Siwachanat/ExArMo/Logbook_Capstan_Drive_Performance_TH.docx

บันทึกการปฏิบัติงานโครงงาน (Project Logbook)

การทดสอบและหาประสิทธิภาพชุดส่งกำลังแคปสแตน

Capstan Drive Performance Test

หัวข้อ | รายละเอียด
โครงงาน | ExArMo — อุปกรณ์ฟื้นฟูข้อศอกแบบสวมใส่ 1 องศาอิสระ (1-DOF Elbow Exoskeleton)
ส่วนของงาน | การทดสอบอัตราทดและประสิทธิภาพของชุดส่งกำลังแคปสแตน
การจัดวาง A | คานยาว 10 cm ต่อกับแกนมอเตอร์โดยตรง (Direct drive)
การจัดวาง B | คานยาว 10 cm ต่อกับดรัมขาออกของชุดแคปสแตน (Through capstan)
วิธีการ | ปรับค่ากระแส I_q เป็นขั้น ๆ แล้ววัดแรงด้วยโหลดเซลล์ (ชุดทดสอบเดียวกับ logbook ค่า K_t วิธีที่ 2)
ชุดส่งกำลัง | Capstan Drive อัตราทดออกแบบ 9 : 1 (ดรัม ⌀11 มม. และ ⌀99 มม., เชือก ⌀2 มม.)
มอเตอร์ | มอเตอร์ที่พันใหม่ 40 รอบ/ฟัน ต่อแบบสตาร์ (K_t = 0.10148 N·m/A)
ไฟล์ข้อมูลดิบ | Test40.csv (direct drive, 80 แถว) และ foc_loadcell_capstan.csv (ผ่านแคปสแตน, 60 แถว)
วันที่เก็บข้อมูล | 12 กรกฎาคม 2569 · วิเคราะห์ผล 16 สิงหาคม 2569
ผู้บันทึก | .................................................................
สถานะ | ☑ ทดลองแล้ว ☑ วิเคราะห์ผลแล้ว ☐ ยืนยันอัตราทดเชิงจลนศาสตร์ ☐ วัดขาลง

# 1. วัตถุประสงค์ของการทดลอง

ในสองการทดลองก่อนหน้านี้เราได้พิสูจน์แล้วว่ามอเตอร์ที่พันใหม่ให้ค่าคงตัวแรงบิดตามทฤษฎี และเราได้ออกแบบชุดส่งกำลังแคปสแตนที่มีอัตราทดตามแบบ 9 : 1 การทดลองนี้เป็นขั้นตอนสุดท้ายของการยืนยันสายส่งกำลังทั้งเส้น คือวัดว่าเมื่อประกอบทุกอย่างเข้าด้วยกันแล้ว แรงบิดที่ออกมาที่ข้อต่อจริง ๆ เป็นเท่าไร

- วัด อัตราขยายแรงบิดรวม (i · η) ของชุดแคปสแตนจากการทดลองจริง
- แยกค่า อัตราทดจริง (i) ออกจาก ประสิทธิภาพเชิงกล (η) เพื่อไม่ให้สับสนระหว่างความคลาดเคลื่อนทางเรขาคณิตกับการสูญเสียพลังงาน
- วัด แรงเสียดทานสถิตที่ชุดแคปสแตนเพิ่มเข้ามา ซึ่งเป็นตัวกำหนดว่าผู้ใช้ต้องออกแรงเท่าไรจึงจะเริ่มขยับแขนกลได้
- ยืนยันว่าแรงบิดที่ข้อต่อเพียงพอต่องานกายภาพบำบัดข้อศอกที่ต้องการประมาณ 2 ถึง 3 N·m

แนวคิดหลักของการทดลอง เราวัดสองครั้งด้วยชุดทดสอบเดียวกัน คานยาวเท่ากัน และโหลดเซลล์ตัวเดียวกัน ต่างกันแค่ว่าคานติดอยู่กับแกนมอเตอร์โดยตรง หรือติดอยู่กับดรัมขาออกของแคปสแตน แล้วนำผลทั้งสองมาหารกัน วิธีนี้ทำให้ความคลาดเคลื่อนที่เหมือนกันทั้งสองครั้งหักล้างกันหมด ซึ่งเป็นจุดแข็งที่สุดของการออกแบบการทดลองนี้ (ดูข้อ 2.2)

# 2. ทฤษฎี

## 2.1 สมการพื้นฐานของชุดส่งกำลัง

ชุดส่งกำลังที่มีอัตราทด i และประสิทธิภาพเชิงกล η จะแปลงแรงบิดขาเข้าเป็นแรงบิดขาออกตามสมการ

τ_out = i · η · τ_in ω_out = ω_in / i

เมื่อรวมกับความสัมพันธ์ระหว่างแรงบิดกับกระแสของมอเตอร์ที่เราหาไว้แล้วในการทดลองค่า K_t จะได้

การจัดวาง A : τ_A = K_t · I_q + b_A

การจัดวาง B : τ_B = ( i · η · K_t ) · I_q + b_B

ดังนั้นถ้าเราพล็อตแรงบิดที่วัดได้เทียบกับกระแสในทั้งสองการจัดวาง แล้วหาความชันของแต่ละเส้น ความชันของเส้น B จะมากกว่าความชันของเส้น A อยู่เท่ากับ i · η พอดี

i · η = ความชัน_B / ความชัน_A

## 2.2 ทำไมการวัดแบบเทียบสองการจัดวางจึงแม่นยำเป็นพิเศษ

จุดแข็งของวิธีนี้อยู่ที่การนำผลสองชุดมาหารกัน เพราะความคลาดเคลื่อนที่ปรากฏเหมือนกันในทั้งสองการวัดจะถูกหักล้างไปหมด

แหล่งความคลาดเคลื่อน | มีผลต่อการวัดเดี่ยว | มีผลต่ออัตราส่วน B ÷ A
ค่าตัวคูณของโหลดเซลล์ | มีผลเต็มที่ | หักล้างหมด (ใช้เซลล์ตัวเดียวกัน)
ระยะแขน r ของคาน | มีผลเต็มที่ | หักล้างหมด (ใช้คานเดียวกัน)
ค่า K_t ของมอเตอร์ | มีผลเต็มที่ | หักล้างหมด (มอเตอร์ตัวเดียวกัน)
ความคลาดเคลื่อนของค่ากระแส I_q ที่รายงาน | มีผลเต็มที่ | หักล้างหมด
ความตั้งฉากของแรงที่กระทำต่อโหลดเซลล์ | มีผลเต็มที่ | หักล้างบางส่วน ถ้าจัดวางเหมือนกัน

เงื่อนไขสำคัญ ประโยชน์ข้อนี้จะเกิดขึ้นก็ต่อเมื่อใช้ โหลดเซลล์ตัวเดียวกัน คานความยาวเท่ากัน และมอเตอร์ตัวเดียวกัน ในทั้งสองการจัดวาง ถ้าเปลี่ยนโหลดเซลล์เพราะพิกัดไม่พอ ความคลาดเคลื่อนจะไม่หักล้างกันอีกต่อไป และต้องสอบเทียบเซลล์ทั้งสองตัวด้วยตุ้มน้ำหนักมาตรฐานชุดเดียวกันแทน

## 2.3 การแยกอัตราทดจริงออกจากประสิทธิภาพ

การทดลองนี้วัดได้โดยตรงเพียงผลคูณ i · η เท่านั้น ไม่สามารถแยกสองตัวนี้ออกจากกันได้ด้วยตัวมันเอง จึงต้องหาค่า i จากแหล่งอื่นก่อน

วิธีหาค่า i | วิธีทำ | ข้อจำกัด
จากแบบทางเรขาคณิต | i = D₂ / D₁ = 99 / 11 = 9.00 | ถ้าร่องเชือกลึกไม่ตรงตามแบบ ค่าจริงจะเพี้ยน
วัดจากเอนโคดเดอร์ (แนะนำ) | หมุนขาออกไปหนึ่งช่วงมุมที่ทราบ แล้วนับมุมที่แกนมอเตอร์หมุนไป i = Δθ_มอเตอร์ / Δθ_ขาออก | ต้องมีเอนโคดเดอร์ทั้งสองฝั่ง หรือวัดมุมขาออกด้วยเครื่องมือ

ทำไมต้องวัด i แยกต่างหาก ใน logbook การออกแบบแคปสแตนเราพบว่า ถ้าร่องเชือกไม่ได้ลึกครึ่งหนึ่งของเส้นผ่านศูนย์กลางเชือก แนวศูนย์กลางเชือกจะเลื่อนไปอยู่ที่ ⌀13 และ ⌀101 ทำให้อัตราทดจริงเหลือเพียง 7.77 แทนที่จะเป็น 9.00 ถ้าเราเหมาเอาว่า i = 9 เสมอ ความคลาดเคลื่อนทางเรขาคณิตนี้จะไปโผล่เป็นค่า η ที่ต่ำผิดปกติ ทำให้สรุปผิดว่าชุดส่งกำลังมีประสิทธิภาพแย่ ทั้งที่จริงแล้วปัญหาอยู่ที่ขนาดของร่อง

เกณฑ์ตรวจสอบง่าย ๆ: ถ้าค่า i · η ที่วัดได้ มากกว่า 9 แสดงว่าอัตราทดจริงต้องมากกว่า 9 แน่นอน เพราะประสิทธิภาพเป็นไปไม่ได้ที่จะเกิน 100 % ในกรณีนั้นให้กลับไปวัดขนาดดรัมและความลึกร่องใหม่

## 2.4 ความหมายของความชันกับจุดตัดแกน

เช่นเดียวกับการทดลองหาค่า K_t เส้นตรงที่ได้จากการทดลองนี้มีสองส่วนที่มีความหมายทางกายภาพต่างกัน และต้องตีความแยกกัน

ส่วนของเส้นตรง | ความหมายทางกายภาพ | สิ่งที่บอกเราได้
ความชัน | การสูญเสียที่แปรผันตามภาระ เช่น ความฝืดของแบริ่งที่เพิ่มตามแรงตึงเชือก และการสูญเสียภายในเนื้อเชือก | ค่า i · η ที่ใช้คำนวณประสิทธิภาพ
จุดตัดแกน b | แรงบิดที่ระบบต้านได้เองโดยไม่ต้องใช้กระแส คือ cogging torque บวกแรงเสียดทานสถิตของแบริ่งและเชือก | แรงที่ผู้ใช้ต้องออกก่อนแขนกลจะเริ่มขยับ (สำคัญมากต่อความรู้สึกในการใช้งาน)

แรงเสียดทานที่ชุดแคปสแตนเพิ่มเข้ามาเอง หาได้จากการเทียบจุดตัดแกนของทั้งสองการจัดวาง โดยต้องแปลงจุดตัดแกนของการจัดวาง A ให้ไปอยู่ที่ฝั่งขาออกก่อน

τ_เสียดทาน,แคปสแตน = b_B − ( i · η ) · b_A

ค่านี้บอกโดยตรงว่าถ้าผู้ใช้จับแขนกลแล้วออกแรงหมุน จะต้องออกแรงบิดอย่างน้อยเท่าไรจึงจะเอาชนะความฝืดของระบบได้ ซึ่งเป็นตัวเลขที่ใช้ตัดสินคุณสมบัติ Backdrivability ได้ตรงที่สุด

## 2.5 ประสิทธิภาพขึ้นกับจุดทำงาน

เนื่องจากมีทั้งส่วนที่แปรผันตามภาระและส่วนที่คงที่ ประสิทธิภาพโดยรวมจึงไม่ใช่ตัวเลขตัวเดียว แต่เปลี่ยนไปตามแรงบิดที่ใช้งาน

η(I_q) = ( ความชัน_B · I_q + b_B ) / [ i · ( ความชัน_A · I_q + b_A ) ]

- ที่แรงบิดต่ำ ค่า b ครองสัดส่วนใหญ่ ประสิทธิภาพจึงต่ำ
- ที่แรงบิดสูง ผลของ b เจือจางลง ประสิทธิภาพจึงเข้าใกล้ค่าที่ได้จากอัตราส่วนความชัน
- เวลารายงานค่าประสิทธิภาพต้องระบุเสมอว่าเป็นค่าที่จุดทำงานใด มิฉะนั้นตัวเลขจะเทียบกันไม่ได้

## 2.6 ค่าที่คาดการณ์ไว้ล่วงหน้า

จากค่า K_t = 0.10148 N·m/A ที่วัดได้ในการทดลองก่อนหน้า และอัตราทดออกแบบ 9 : 1 เราคาดว่าจะได้ค่าดังตาราง

สมมติฐาน | ความชัน B (N·m/A) | แรงบิดที่ I_q = 4 A | แรงที่คาน 10 cm
η = 1.00 (ไม่มีการสูญเสีย) | 0.9133 | 3.65 N·m | 36.5 N (3.7 kg)
η = 0.90 | 0.8220 | 3.29 N·m | 32.9 N (3.4 kg)
η = 0.87 | 0.7946 | 3.18 N·m | 31.8 N (3.2 kg)
η = 0.80 | 0.7307 | 2.92 N·m | 29.2 N (3.0 kg)

ส่วนการจัดวาง A ที่กระแสเดียวกัน 4 A จะได้แรงบิด 0.406 N·m คิดเป็นแรงที่คานเพียง 4.06 N หรือประมาณ 414 กรัม

[ วางรูปที่นี่ / Insert image here ]

แผนภาพหลักการทดลอง — เปรียบเทียบการจัดวาง A (ต่อแกนมอเตอร์ตรง) กับ B (ผ่านชุดแคปสแตน)

รูปที่ 1 แผนภาพหลักการทดลอง — เปรียบเทียบการจัดวาง A (ต่อแกนมอเตอร์ตรง) กับ B (ผ่านชุดแคปสแตน)

# 3. เทคนิคและวิธีการทดลอง

## 3.1 ชุดทดสอบ

ใช้ชุดทดสอบเดียวกับที่พัฒนาไว้ในการวัดค่า K_t วิธีที่ 2 คือโหลดเซลล์ต่อกับบอร์ด Arduino ส่งค่าเข้าโปรแกรม Python GUI พร้อมกับค่ากระแส I_q จากเฟิร์มแวร์ SimpleFOC แล้วบันทึกทั้งสองค่าพร้อมเวลาลงไฟล์ CSV

รายการ | การจัดวาง A (Direct) | การจัดวาง B (Through capstan)
คานติดที่ไหน | แกนมอเตอร์โดยตรง | ดรัมขาออก ⌀99 มม. ของแคปสแตน
ความยาวคาน | 10 cm | 10 cm (คานเดียวกัน)
โหลดเซลล์ | ตัวเดียวกัน | ตัวเดียวกัน
สิ่งที่วัดได้ | K_t ของมอเตอร์ | K_t × i × η ที่ข้อต่อ
ช่วงแรงที่คาดว่าจะเจอ | 0 ถึงประมาณ 4 N | 0 ถึงประมาณ 37 N

## 3.2 การเลือกพิกัดของโหลดเซลล์

นี่คือประเด็นที่ต้องวางแผนก่อนเริ่มทดลอง เพราะแรงที่เกิดขึ้นในสองการจัดวางต่างกันเกือบสิบเท่า

- ถ้าใช้โหลดเซลล์ตัวเดียวกันทั้งสองการจัดวาง ความคลาดเคลื่อนจะหักล้างกันตามข้อ 2.2 ซึ่งเป็นข้อดีที่สำคัญมาก แต่ต้องเลือกพิกัดให้ครอบคลุมแรงสูงสุดของการจัดวาง B คือประมาณ 5 กิโลกรัม และในการจัดวาง A เราจะใช้เพียงราว 8 % ของพิกัดเท่านั้น
- ข้อควรระวัง: ความแม่นยำของโหลดเซลล์มักระบุเป็นเปอร์เซ็นต์ของพิกัดเต็ม ดังนั้นการวัดที่เพียง 8 % ของพิกัดจะมีความคลาดเคลื่อนสัมพัทธ์สูงกว่าปกติราวสิบเท่า ต้องเก็บจุดข้อมูลให้มากเพื่อชดเชยด้วยการเฉลี่ยทางสถิติ
- ทางเลือก: ถ้าจำเป็นต้องใช้โหลดเซลล์คนละตัว ต้องสอบเทียบทั้งสองตัวด้วยตุ้มน้ำหนักมาตรฐานชุดเดียวกัน และต้องรายงานความไม่แน่นอนของการสอบเทียบเข้าไปในผลด้วย เพราะข้อดีเรื่องการหักล้างความคลาดเคลื่อนหายไปแล้ว

## 3.3 ขั้นตอนการทดลอง

1. วัดอัตราทดจริง i ก่อนเป็นอันดับแรก โดยหมุนดรัมขาออกไปหนึ่งช่วงมุมที่ทราบค่า แล้วอ่านมุมที่แกนมอเตอร์หมุนไปจากเอนโคดเดอร์ ทำซ้ำหลายครั้งแล้วเฉลี่ย
2. ตั้งความตึงเชือกให้ได้ตามที่กำหนด แล้วบันทึกวิธีตั้งไว้ให้ชัดเจน เพราะความตึงมีผลต่อทั้งความฝืดและความแข็งของระบบ
3. ประกอบการจัดวาง A ติดคานเข้ากับแกนมอเตอร์ จัดให้คานอยู่แนวระนาบและกดตรงแกนวัดของโหลดเซลล์
4. ตั้งศูนย์โหลดเซลล์ขณะยังไม่จ่ายกระแส แล้วตั้งเฟิร์มแวร์เป็นโหมดแรงบิดพร้อมจำกัดกระแสสูงสุด
5. แรมป์ค่า I_q ขึ้นทีละขั้นอย่างช้า ๆ จนถึงค่าสูงสุดที่กำหนด แล้วลดกลับลงมาที่ศูนย์ตามเส้นทางเดิม บันทึกลง CSV
6. ถอดคานออก ประกอบชุดแคปสแตน แล้วติดคานตัวเดิมเข้ากับดรัมขาออก จัดวางให้เหมือนเดิมทุกประการ
7. ทำซ้ำขั้นตอนที่ 4 และ 5 สำหรับการจัดวาง B
8. ทำซ้ำทั้งชุดในทิศทางการหมุนตรงข้าม เพราะชุดแคปสแตนอาจมีความฝืดไม่เท่ากันในสองทิศทาง
9. นำไฟล์ CSV มาฟิตเส้นตรงแบบมีจุดตัดแกน หาความชันและจุดตัดแกนของแต่ละการจัดวาง แล้วคำนวณตามสมการในข้อ 2

## 3.4 กติกาการทำความสะอาดข้อมูลที่ใช้จริง

ข้อมูลดิบเก็บที่ขั้นกระแสละ 0.2 A ค้างขั้นละประมาณ 2 วินาที ได้ประมาณ 4 แซมเปิลต่อขั้น (คาบการสุ่มราว 0.5 วินาที) ก่อนนำไปฟิตเส้นตรงได้กำหนดกติกาการคัดข้อมูลไว้สามข้อ

1. ตัดสองแซมเปิลแรกของทุกขั้นกระแสทิ้ง เพราะค่าน้ำหนักจากโหลดเซลล์ตอบสนองช้ากว่ากระแสประมาณหนึ่งคาบการสุ่ม แซมเปิลแรกจึงยังเป็นน้ำหนักของขั้นก่อนหน้า และกระแสยังอยู่ในช่วงเปลี่ยนผ่าน แล้วใช้ค่าเฉลี่ยของสองแซมเปิลท้ายที่เป็นช่วงคงตัวแทน
2. ฝั่งแคปสแตน ตัดขั้น 0.2 A และ 0.4 A ทิ้งทั้งหมด เพราะค่าน้ำหนักที่อ่านได้เกือบเป็นศูนย์ และตำแหน่งเชิงมุมยังอยู่ที่ประมาณ −4.2 rad แสดงว่าแขนยังหมุนเก็บระยะหย่อนของระบบอยู่ ยังไม่สัมผัสโหลดเซลล์ พอถึงขั้น 0.6 A ตำแหน่งกระโดดไปที่ +2.5 rad จึงถือว่าเริ่มสัมผัส
3. ใช้ค่า I_q ที่วัดได้จริงเป็นแกน x ไม่ใช่ค่าเป้าหมายที่สั่ง เพราะกระแสจริงเบี่ยงจากค่าเป้าหมายได้มาก เช่นขั้นที่สั่ง 1.8 A วัดได้จริง 2.013 A

เหตุผลที่ไม่บังคับเส้นให้ผ่านจุดกำเนิด ระบบมีออฟเซตจริงจากแรงเสียดทานสถิตและแรงตึงเริ่มต้นของเชือก ถ้าบังคับให้เส้นผ่านศูนย์ ออฟเซตนั้นจะไปบิดค่าความชัน ในกรณีนี้ถ้าบังคับผ่านศูนย์จะได้อัตราขยาย 8.95 ซึ่งแปลว่าประสิทธิภาพ 99.5 % ซึ่งสูงเกินจริงอย่างชัดเจน เป็นบทเรียนเดียวกับที่พบในการทดลองหาค่า K_t

## 3.5 เทคนิคที่ทำให้ผลการวัดเชื่อถือได้

- ใช้คานตัวเดิมและโหลดเซลล์ตัวเดิม และอย่าเปลี่ยนจุดยึดหรือระยะ r ระหว่างสองการจัดวาง นี่คือเงื่อนไขที่ทำให้ความคลาดเคลื่อนหักล้างกัน
- วัดทั้งสองการจัดวางในวันเดียวกัน เพราะอุณหภูมิมีผลต่อทั้งค่า K_t ของมอเตอร์และการดริฟต์ของโหลดเซลล์
- ดึงเชือกทิ้งไว้ก่อนติดตั้ง (Pre-stretch) และตั้งความตึงใหม่ก่อนเริ่ม เพราะเชือกที่ยังไม่ผ่านการยืดตัวจะคลายตัวระหว่างทดลอง ทำให้ความชันไหลลง
- วัดซ้ำที่หลายตำแหน่งเชิงมุมของดรัม เพราะทั้ง cogging torque ของมอเตอร์และตำแหน่งของเชือกบนร่องเปลี่ยนไปตามมุม
- เก็บทั้งขาขึ้นและขาลง ผลต่างระหว่างสองขาคือขนาดของฮิสเทอรีซิสจากแรงเสียดทาน ซึ่งเป็นข้อมูลที่มีค่าในตัวเอง
- ตรวจว่าเชือกไม่ลื่นระหว่างการทดลอง โดยทำเครื่องหมายที่เชือกกับดรัม หรือเทียบมุมมอเตอร์กับมุมขาออกก่อนและหลังทดลอง ถ้าเลื่อนแสดงว่าเชือกลื่นและข้อมูลชุดนั้นใช้ไม่ได้
- ตรวจความแข็งแรงของโครงยึด ที่การจัดวาง B แรงที่เกิดขึ้นสูงถึงเกือบ 40 N ถ้าโครงยึดโก่งตัว มุมของคานจะเปลี่ยนและค่าที่วัดได้จะต่ำกว่าความจริง

[ วางรูปที่นี่ / Insert image here ]

ชุดทดสอบจริง — การจัดวาง A ต่อคานเข้ากับแกนมอเตอร์โดยตรง

รูปที่ 2 ชุดทดสอบจริง — การจัดวาง A ต่อคานเข้ากับแกนมอเตอร์โดยตรง

[ วางรูปที่นี่ / Insert image here ]

ชุดทดสอบจริง — การจัดวาง B ต่อคานเข้ากับดรัมขาออกของชุดแคปสแตน

รูปที่ 3 ชุดทดสอบจริง — การจัดวาง B ต่อคานเข้ากับดรัมขาออกของชุดแคปสแตน

# 4. ผลการทดลอง

## 4.1 อัตราทดจริง — ยังไม่ได้วัด

ข้อจำกัดที่ต้องบันทึกไว้ ในการทดลองครั้งนี้เรายังไม่ได้วัดอัตราทดเชิงจลนศาสตร์จริง ค่าประสิทธิภาพที่รายงานทั้งหมดจึงอยู่บนสมมติฐานว่าอัตราทดเท่ากับค่าออกแบบคือ 9.00 พอดี ถ้าอัตราทดจริงต่างจากนี้ ค่าประสิทธิภาพจะเปลี่ยนไปในสัดส่วนเดียวกันทันที การวัดอัตราทดจริงจึงเป็นงานลำดับแรกที่ต้องทำในการทดลองครั้งถัดไป โดยหมุนมอเตอร์ให้ครบ 9 รอบแล้วอ่านมุมข้อต่อจากเอนโคดเดอร์ทั้งสองฝั่ง ซึ่งควรได้ 1 รอบพอดี

## 4.2 ข้อมูลที่ทำความสะอาดแล้ว — การจัดวาง A (Direct drive)

เป้าหมาย (A) | I_q วัดจริง (A) | น้ำหนัก (g) | τ (N·m)
0.2 | 0.2610 | 29.22 | 0.0287
0.4 | 0.3341 | 50.41 | 0.0494
0.6 | 0.5331 | 73.16 | 0.0718
0.8 | 0.7523 | 93.35 | 0.0916
1.0 | 1.0138 | 113.93 | 0.1118
1.2 | 1.1160 | 135.78 | 0.1332
1.4 | 1.4548 | 156.63 | 0.1537
1.6 | 1.6069 | 177.74 | 0.1744
1.8 | 1.7653 | 200.04 | 0.1962
2.0 | 2.0248 | 220.84 | 0.2166
2.2 | 2.2006 | 241.66 | 0.2371
2.4 | 2.5313 | 262.87 | 0.2579
2.6 | 2.6699 | 285.21 | 0.2798
2.8 | 2.7937 | 307.33 | 0.3015
3.0 | 3.0284 | 328.19 | 0.3220
3.2 | 3.2421 | 348.56 | 0.3419
3.4 | 3.4187 | 367.98 | 0.3610
3.6 | 3.6511 | 387.84 | 0.3805
3.8 | 3.8165 | 410.19 | 0.4024
4.0 | 3.9650 | 429.54 | 0.4214

ผลการฟิต: K_t = 0.1021 N·m/A · b = 0.0114 N·m · R² = 0.9982 · จำนวนจุดข้อมูล 20 จุด

ค่า K_t ที่ได้จากชุดนี้ต่างจากค่าที่วัดได้ในการทดลองก่อนหน้า (0.097 ถึง 0.101 N·m/A) ประมาณ 5 % ซึ่งถือว่ายืนยันกันได้ และการวัดซ้ำในชุดการทดลองเดียวกันนี้เองเป็นสิ่งจำเป็น เพื่อให้การเปรียบเทียบอยู่บนเงื่อนไขเดียวกันทั้งหมด

## 4.3 ข้อมูลที่ทำความสะอาดแล้ว — การจัดวาง B (ผ่านแคปสแตน)

เป้าหมาย (A) | I_q วัดจริง (A) | น้ำหนัก (g) | τ (N·m) | residual (N·m)
0.6 | 0.5683 | 672.56 | 0.6598 | −0.107
0.8 | 0.8561 | 976.51 | 0.9580 | −0.041
1.0 | 1.0315 | 1058.15 | 1.0380 | −0.102
1.2 | 1.2445 | 1316.36 | 1.2913 | −0.021
1.4 | 1.3867 | 1615.58 | 1.5849 | +0.158
1.6 | 1.5315 | 1709.74 | 1.6773 | +0.134
1.8 | 2.0134 | 1972.28 | 1.9348 | +0.003
2.0 | 2.0298 | 2033.22 | 1.9946 | +0.049
2.2 | 2.1425 | 2113.05 | 2.0729 | +0.037
2.4 | 2.3128 | 2320.75 | 2.2767 | +0.103
2.6 | 2.7168 | 2452.99 | 2.4064 | −0.093
2.8 | 2.8290 | 2643.44 | 2.5932 | +0.003
3.0 | 3.0610 | 2706.40 | 2.6550 | −0.122

ผลการฟิต: K_t,j = 0.807 N·m/A · b = 0.308 N·m · R² = 0.979 · จำนวนจุดข้อมูล 13 จุด (ตัดขั้น 0.2 และ 0.4 A ออก)

[ วางรูปที่นี่ / Insert image here ]

กราฟแรงบิดเทียบกระแสของทั้งสองการจัดวาง แสดงเส้นถดถอยและความชันที่ต่างกัน

รูปที่ 4 กราฟแรงบิดเทียบกระแสของทั้งสองการจัดวาง แสดงเส้นถดถอยและความชันที่ต่างกัน

## 4.4 การคำนวณผลลัพธ์

1) อัตราขยายแรงบิดรวมที่วัดได้

N * eta = K_t,j / K_t = 0.807 / 0.1021 = 7.90

2) ประสิทธิภาพการส่งกำลัง (ใช้อัตราทดออกแบบ N = 9)

eta = 7.90 / 9 = 0.878 = 87.8 %

3) ออฟเซตส่วนเกินที่ฝั่งขาออก

c = b_B - (N*eta) * b_A = 0.3083 - 7.90 * 0.0114 = +0.218 N*m

4) แรงบิดที่ข้อต่อตามเส้นฟิต

Iq = 3.0 A -> tau_j = 0.807*3.0 + 0.308 = 2.73 N*m

(ค่าที่วัดได้จริงที่ขั้น 3.0 A คือ 2.655 N*m)

ผลลัพธ์ | ค่าที่ได้ | หมายเหตุ
K_t ฝั่งมอเตอร์ (วัดซ้ำในชุดเดียวกัน) | 0.1021 N·m/A | R² = 0.9982, n = 20
K_t,j ฝั่งข้อต่อ | 0.807 N·m/A | R² = 0.979, n = 13
จุดตัดแกน b ฝั่งมอเตอร์ | 0.0114 N·m | cogging + เสียดทานมอเตอร์
จุดตัดแกน b ฝั่งข้อต่อ | 0.308 N·m | ดูข้อสังเกตในข้อ 4.5
อัตราขยายแรงบิดที่วัดได้ (N·η) | 7.90 | ต้องน้อยกว่า 9 — ผ่านเกณฑ์
ประสิทธิภาพการส่งกำลัง η | 87.8 % | อยู่ในช่วงปกติของแคปสแตน 85–95 %
แรงบิดที่ข้อต่อที่ 3.0 A | 2.66 N·m (วัดได้จริง) | เกินความต้องการ 2–3 N·m

ข้อสรุปหลัก ประสิทธิภาพการส่งกำลัง 87.8 % อยู่ในช่วงปกติของชุดส่งกำลังแบบแคปสแตน และตรงกับค่า 87 % ที่เคยอ้างไว้ในเอกสารออกแบบ การสูญเสียประมาณ 12 % คาดว่ามาจากแรงเสียดทานที่จุดรองรับข้อต่อ การงอตัวของเชือกรอบดรัม และการเสียรูปยืดหยุ่นของโครงสร้าง

## 4.5 ข้อสังเกตสำคัญ — จุดตัดแกนฝั่งแคปสแตนสูงเกินกว่าที่กฎอนุรักษ์พลังงานอนุญาต

เมื่อนำสมการเส้นตรงของทั้งสองการจัดวางมาเขียนใหม่ให้อยู่ในรูปความสัมพันธ์ระหว่างแรงบิดขาออกกับแรงบิดขาเข้า จะได้

τ_B = ( N·η ) · τ_A + c โดย c = b_B − ( N·η )·b_A = +0.218 N·m

ชุดส่งกำลังทำได้แค่ทำให้แรงบิดหายไป ไม่สามารถสร้างแรงบิดเพิ่มขึ้นมาเองได้ ค่า c จึงควรเป็นศูนย์หรือติดลบ แต่ค่าที่ได้กลับเป็นบวก ซึ่งหมายความว่าที่กระแสต่ำ แรงบิดที่วัดได้ที่ขาออกมีค่ามากกว่า 9 เท่าของแรงบิดที่มอเตอร์สร้าง ซึ่งเป็นไปไม่ได้ทางฟิสิกส์

ตรวจสอบเป็นจุด ๆ โดยเทียบแรงบิดที่วัดได้จริงกับเก้าเท่าของแรงบิดมอเตอร์ที่กระแสเดียวกัน

I_q (A) | τ ที่วัดได้ (N·m) | 9 × τ มอเตอร์ (N·m) | อัตราส่วน
0.568 | 0.660 | 0.625 | 1.056
1.032 | 1.038 | 1.050 | 0.988
1.387 | 1.585 | 1.376 | 1.151
2.013 | 1.935 | 1.952 | 0.991
2.313 | 2.277 | 2.227 | 1.022
2.717 | 2.406 | 2.598 | 0.926
3.061 | 2.655 | 2.914 | 0.911

จะเห็นว่าที่กระแสต่ำถึงกลาง อัตราส่วนเกิน 1 (สูงสุด 1.15) แล้วค่อย ๆ ลดลงต่ำกว่า 1 เมื่อกระแสสูงขึ้น รูปแบบนี้คือลายเซ็นของออฟเซตคงที่ที่บวกเพิ่มเข้ามาในค่าที่วัดได้ ไม่ใช่ลักษณะของประสิทธิภาพที่แท้จริง

สาเหตุที่เป็นไปได้ เรียงตามความน่าจะเป็น

1. น้ำหนักของแขนโมเมนต์และชุดยึดฝั่งขาออกกดทับโหลดเซลล์ — ออฟเซต 0.218 N·m ที่ระยะ 10 ซม. เทียบเท่ามวลประมาณ 222 กรัม ซึ่งใกล้เคียงกับน้ำหนักของแขนพร้อมดุมยึดอย่างมาก จึงเป็นสาเหตุที่น่าจะเป็นที่สุด
2. การตั้งศูนย์โหลดเซลล์ทำตอนที่แขนยังไม่สัมผัส ตำแหน่งเชิงมุมขณะตั้งศูนย์อยู่ที่ประมาณ −4.2 rad คือแขนยังลอยอยู่ พอแขนเคลื่อนมาสัมผัสที่ 0.6 A น้ำหนักส่วนนี้จึงเพิ่มเข้ามาโดยไม่ได้ถูกหักออก
3. แรงตึงเริ่มต้นของเชือกดันแขนขาออกให้กดโหลดเซลล์อยู่ก่อนแล้ว
4. การประมาณค่านอกช่วง เส้นฟิตมาจากช่วง 0.57 ถึง 3.06 A แต่ระบบมีช่วงไร้การตอบสนองอยู่ต่ำกว่า 0.6 A ความสัมพันธ์จึงไม่เป็นเส้นตรงตลอดช่วง การลากเส้นย้อนกลับไปที่ศูนย์จึงไม่มีความหมายทางกายภาพโดยตรง

ผลกระทบต่อข้อสรุปหลัก ไม่มีผล เพราะออฟเซตคงที่ไม่กระทบต่อความชันของเส้นถดถอย ค่าประสิทธิภาพ 87.8 % ที่คำนวณจากอัตราส่วนความชันจึงยังใช้ได้ นี่คือเหตุผลที่เราออกแบบให้ใช้วิธีอัตราส่วนความชันตั้งแต่ต้น และเป็นตัวอย่างที่ชัดเจนว่าทำไมจึงห้ามบังคับเส้นให้ผ่านจุดกำเนิด

สิ่งที่ห้ามทำ ห้ามนำค่า b = 0.308 N·m ไปตีความตรง ๆ ว่าเป็นแรงเสียดทานสถิตของชุดส่งกำลัง เพราะยังปนอยู่กับออฟเซตจากการวัด ถ้าต้องการตัวเลขแรงเสียดทานที่ใช้อ้างอิงเรื่อง Backdrivability ได้จริง ต้องวัดแรงบิดฝืนย้อนกลับ (Backdrive torque) ที่ข้อต่อโดยตรง ซึ่งเป็นการทดลองแยกต่างหาก

## 4.6 แรงบิดที่ข้อต่อในย่านใช้งาน

I_q (A) | τ มอเตอร์ (N·m) | τ ข้อต่อ ตามเส้นฟิต (N·m) | เทียบความต้องการ 2–3 N·m
1.0 | 0.114 | 1.12 | ยังไม่พอ
2.0 | 0.216 | 1.92 | เกือบพอ
3.0 | 0.318 | 2.73 | พอแล้ว
4.0 | 0.420 | 3.54 | เกินพอ (ยังไม่ได้ทดสอบจริง)

การทดลองฝั่งแคปสแตนเก็บข้อมูลถึงเพียง 3.0 A ค่าที่ 4.0 A จึงเป็นการประมาณจากเส้นฟิต ยังต้องยืนยันด้วยการทดลองจริงพร้อมตรวจสอบขีดจำกัดกระแสต่อเนื่องของบอร์ดขับและความร้อนของมอเตอร์

[ วางรูปที่นี่ / Insert image here ]

กราฟค่าคลาดเคลื่อน (residual) ของการฟิตฝั่งแคปสแตน แสดงการแกว่งสลับช่วงตามตำแหน่งเชือกบนดรัม

รูปที่ 5 กราฟค่าคลาดเคลื่อน (residual) ของการฟิตฝั่งแคปสแตน แสดงการแกว่งสลับช่วงตามตำแหน่งเชือกบนดรัม

# 5. ปัญหาที่พบและแนวทางแก้ไข

## 5.1 ปัญหาที่พบจากผลการทดลองจริง

ปัญหาที่พบ | สาเหตุ | วิธีแก้
ที่ขั้น 0.2 และ 0.4 A น้ำหนักที่อ่านได้เกือบเป็นศูนย์ ต้องตัดข้อมูลทิ้ง | แขนขาออกยังหมุนเก็บระยะหย่อนของระบบอยู่ ยังไม่สัมผัสโหลดเซลล์ (ตำแหน่งอยู่ที่ −4.2 rad จนกระโดดไป +2.5 rad ที่ขั้น 0.6 A) | เก็บระยะหย่อนออกด้วยมือให้แขนสัมผัสโหลดเซลล์ก่อน แล้วจึงตั้งศูนย์และเริ่มแรมป์กระแสจากศูนย์ จะได้ข้อมูลครบทุกขั้นและจุดตัดแกนมีความหมายจริง
จุดตัดแกนฝั่งแคปสแตนสูงเกินกว่าที่พลังงานอนุญาต (+0.218 N·m ส่วนเกิน) | น้ำหนักแขนและชุดยึดฝั่งขาออกกดโหลดเซลล์ โดยตั้งศูนย์ไว้ตอนแขนยังลอยอยู่ | ชั่งน้ำหนักแขนและชุดยึดไว้ แล้วตั้งศูนย์ขณะแขนสัมผัสโหลดเซลล์แล้วที่กระแสศูนย์ (ดูข้อ 4.5)
R² ฝั่งแคปสแตนเพียง 0.979 ต่ำกว่าฝั่ง direct (0.998) และค่าคลาดเคลื่อนแกว่งสลับช่วงถึง ±0.16 N·m | แรงเสียดทานและความแข็งเกร็งแปรผันตามตำแหน่งของเชือกบนดรัม ประกอบกับตำแหน่งข้อต่อเลื่อนสะสมจาก 2.51 ไป 2.97 rad ตลอดการทดสอบ แสดงว่าเชือกและโครงยึดยืดตัวภายใต้โหลด | วัดซ้ำหลายตำแหน่งเชิงมุมของดรัมแล้วเฉลี่ย เสริมความแข็งแรงของโครงยึด และดึงเชือกทิ้งไว้ก่อนติดตั้ง
กระแสที่วัดได้จริงเบี่ยงจากค่าที่สั่งมาก เช่นสั่ง 1.8 A วัดได้ 2.013 A ซึ่งสูงกว่าขั้นที่สั่ง 2.0 A | ลูปกระแสยังตามค่าสั่งได้ไม่แม่น หรือค่าที่รายงานมีสัญญาณรบกวน | ใช้ค่า I_q ที่วัดจริงเป็นแกน x เสมอ (ทำแล้วในการวิเคราะห์นี้) และจูนลูปกระแสให้แม่นขึ้นในการทดลองครั้งถัดไป
ค่าน้ำหนักตามหลังค่ากระแสประมาณหนึ่งคาบการสุ่ม | โหลดเซลล์และ HX711 มีอัตราสุ่มต่ำกว่าลูปควบคุมมาก | ตัดสองแซมเปิลแรกของทุกขั้นทิ้ง แล้วใช้ค่าเฉลี่ยของช่วงคงตัว หรือเพิ่มเวลาค้างต่อขั้นให้นานขึ้น
ยังไม่ได้วัดฮิสเทอรีซิส | การทดลองครั้งนี้แรมป์กระแสขึ้นอย่างเดียว ไม่ได้เก็บขาลง | เก็บข้อมูลขาลงเพิ่มในการทดลองครั้งถัดไป เพื่อประเมินแรงเสียดทานจากผลต่างของสองขา
ยังไม่ได้ยืนยันอัตราทดจริง | ค่าประสิทธิภาพทั้งหมดอิงสมมติฐานว่าอัตราทดเท่ากับค่าออกแบบ 9.00 พอดี | หมุนมอเตอร์ให้ครบ 9 รอบแล้วอ่านมุมข้อต่อจากเอนโคดเดอร์สองฝั่ง ซึ่งควรได้ 1 รอบพอดี

## 5.2 ปัญหาด้านชุดส่งกำลังแคปสแตน

ปัญหาที่พบ | สาเหตุ | วิธีแก้
ค่า N · η ที่วัดได้ต่ำกว่าที่คาด | อัตราทดจริงอาจไม่ถึง 9 เพราะร่องเชือกลึกไม่ตรงตามแบบ ทำให้แนวศูนย์กลางเชือกเลื่อน | วัดอัตราทดจริงด้วยเอนโคดเดอร์ และตรวจความลึกร่องด้วย Section Analysis
ความชันไหลลงเรื่อย ๆ ระหว่างการทดลอง | เชือกยืดตัว (Creep) โดยเฉพาะช่วงการใช้งานแรก ๆ ทำให้ความตึงลดลง | ดึงเชือกทิ้งไว้ก่อนติดตั้ง และตั้งความตึงใหม่ก่อนเริ่มทุกชุดการทดลอง
ค่าที่วัดได้กระโดดลงทันทีแล้วไม่กลับ | เชือกลื่นบนดรัมเล็ก เพราะรอบพันน้อยเกินไปหรือความตึงเริ่มต้นต่ำ | เพิ่มรอบตายเป็น 2 ถึง 3 รอบ ทำเครื่องหมายที่เชือกเพื่อตรวจการลื่น และทิ้งข้อมูลชุดที่ลื่น
ตำแหน่งข้อต่อเลื่อนสะสมตลอดการทดสอบ | เชือกและโครงยึดยืดตัวยืดหยุ่นภายใต้โหลดที่เพิ่มขึ้น | เสริมความแข็งแรงโครงยึด และบันทึกตำแหน่งเริ่มต้นกับสิ้นสุดทุกครั้งเพื่อประเมินความแข็งเชิงบิด
ต้องจ่ายกระแสถึงประมาณ 0.6 A แขนจึงเริ่มสัมผัสโหลดเซลล์ | ระยะหย่อนของระบบส่งกำลังและความตึงเชือกที่ยังไม่พอ | ตั้งความตึงเชือกให้เหมาะสมและเก็บระยะหย่อนก่อนเริ่มทดลอง หรือใช้กลไกปรับความตึงที่ออกแบบไว้

## 5.3 ปัญหาด้านชุดทดสอบและการวัด

ปัญหาที่พบ | สาเหตุ | วิธีแก้
แรงในการจัดวาง B สูงกว่ามาก จนพิสัยการใช้งานของโหลดเซลล์ไม่สมดุลกับการจัดวาง A | แรงบิดที่ขาออกสูงกว่าเกือบ 10 เท่า แต่ใช้คานยาวเท่าเดิม | เลือกโหลดเซลล์พิกัดอย่างน้อย 5 กิโลกรัมตั้งแต่แรก และจำกัดกระแสสูงสุดในเฟิร์มแวร์ก่อนเริ่ม
ข้อมูลของการจัดวาง A มีสัดส่วนการใช้พิสัยต่ำ | ความแม่นยำของโหลดเซลล์ระบุเป็นเปอร์เซ็นต์ของพิกัดเต็ม การวัดที่ปลายล่างจึงมีความคลาดเคลื่อนสัมพัทธ์สูงกว่า | เก็บจุดข้อมูลให้มากขึ้นเพื่อเฉลี่ยทางสถิติ (ในชุดนี้ใช้ 20 จุด ซึ่งได้ R² = 0.9982 จึงถือว่าเพียงพอ)
ระยะ r ของสองการจัดวางอาจไม่เท่ากันจริง | จุดยึดคานบนดรัมขาออกกับบนแกนมอเตอร์อยู่คนละตำแหน่ง | ใช้คานตัวเดียวกันและวัดระยะจากแกนหมุนถึงจุดสัมผัสด้วยเวอร์เนียทั้งสองครั้ง
โครงยึดโก่งตัวที่แรงสูง | แรงที่ขาออกสูงถึงเกือบ 30 N ทำให้โครงเสียรูป มุมคานเปลี่ยน ค่าที่วัดได้ต่ำกว่าจริง | เสริมความแข็งแรงของโครงยึด และตรวจด้วยไดอัลเกจที่จุดยึด
คานไม่ตั้งฉากกับแกนวัดของโหลดเซลล์ | แรงที่วัดได้เป็นเพียงองค์ประกอบตามแกน ทำให้ต่ำกว่าจริง | จัดวางให้ตั้งฉากทั้งสองการจัดวาง และใช้จุดสัมผัสแบบปลายมนเพื่อไม่ให้เกิดแรงด้านข้าง

## 5.4 ข้อควรระวังในการตีความ

- ค่าที่วัดได้เป็นประสิทธิภาพในสภาวะสถิต ยังไม่ครอบคลุมการสูญเสียขณะเคลื่อนที่ เช่น การเสียดสีของเชือกขณะม้วนเข้าและคลายออก ประสิทธิภาพขณะเคลื่อนที่จริงมักต่ำกว่าค่านี้เล็กน้อย
- ค่า N · η ไม่ใช่ประสิทธิภาพ ต้องหารด้วยอัตราทดจริงที่วัดได้ ไม่ใช่ค่าออกแบบ ซึ่งในการทดลองนี้ยังไม่ได้วัด จึงถือเป็นข้อจำกัดที่ต้องระบุไว้ทุกครั้งที่รายงานตัวเลข 87.8 %
- ห้ามนำจุดตัดแกนฝั่งแคปสแตนไปตีความเป็นแรงเสียดทานโดยตรง เพราะยังปนกับออฟเซตจากการวัด ต้องวัด Backdrive torque แยกต่างหาก
- รายงานประสิทธิภาพต้องระบุจุดทำงานเสมอ เพราะเมื่อมีทั้งส่วนที่แปรตามภาระและส่วนคงที่ ประสิทธิภาพโดยรวมย่อมเปลี่ยนตามแรงบิดที่ใช้งาน

# 6. สรุปและงานถัดไป

การทดลองนี้วัดประสิทธิภาพการส่งกำลังของชุดแคปสแตนได้เท่ากับ 87.8 % โดยวัดจากอัตราส่วนความชันของเส้นถดถอยระหว่างการต่อคานเข้ากับแกนมอเตอร์โดยตรง กับการต่อคานเข้ากับดรัมขาออก ค่านี้อยู่ในช่วงปกติของชุดส่งกำลังแบบแคปสแตนที่ 85 ถึง 95 % และตรงกับตัวเลข 87 % ที่เคยอ้างไว้ในเอกสารออกแบบ พร้อมทั้งยืนยันได้ว่าแรงบิดที่ข้อต่อ 2.66 N·m ที่กระแส 3 A เพียงพอต่อความต้องการของงานกายภาพบำบัดข้อศอก

บทเรียนเชิงวิธีการที่สำคัญที่สุดจากการทดลองนี้มีสองข้อ ข้อแรกคือการใช้อัตราส่วนความชันทำให้ผลลัพธ์ทนทานต่อออฟเซตจากการวัด ซึ่งพิสูจน์ตัวเองอย่างชัดเจนเมื่อเราพบว่าจุดตัดแกนฝั่งแคปสแตนมีค่าสูงเกินกว่าที่กฎอนุรักษ์พลังงานอนุญาต แต่ข้อสรุปเรื่องประสิทธิภาพก็ยังไม่ได้รับผลกระทบ ข้อที่สองคือถ้าเราบังคับให้เส้นถดถอยผ่านจุดกำเนิด จะได้ประสิทธิภาพ 99.5 % ซึ่งสูงเกินจริงอย่างเห็นได้ชัด เป็นบทเรียนเดียวกับที่พบในการทดลองหาค่า K_t

งานถัดไปที่ต้องดำเนินการ:

1. ยืนยันอัตราทดเชิงจลนศาสตร์ โดยหมุนมอเตอร์ให้ครบ 9 รอบแล้วอ่านมุมข้อต่อจากเอนโคดเดอร์ทั้งสองฝั่ง ซึ่งควรได้ 1 รอบพอดี ขั้นตอนนี้จะแยกความคลาดเคลื่อนเชิงเรขาคณิตออกจากการสูญเสียพลังงานได้เด็ดขาด และทำให้ตัวเลข 87.8 % หนักแน่นขึ้นมาก
2. แก้ปัญหาออฟเซตด้วยการชั่งน้ำหนักแขนและชุดยึดฝั่งขาออก แล้วตั้งศูนย์โหลดเซลล์ขณะแขนสัมผัสโหลดเซลล์แล้วที่กระแสศูนย์ จากนั้นวัดซ้ำเพื่อให้จุดตัดแกนมีความหมายทางกายภาพ
3. เก็บข้อมูลขาลงเพิ่มเพื่อประเมินฮิสเทอรีซิสจากแรงเสียดทาน
4. วัดแรงบิดฝืนย้อนกลับ (Backdrive torque) ที่ข้อต่อโดยตรง ทั้งทิศงอและทิศเหยียด และวัดที่หลายตำแหน่งมุม เพื่อยืนยันคุณสมบัติด้านความปลอดภัย
5. หาแรงบิดต่อเนื่องสูงสุดที่ใช้งานได้จริง โดยตรวจขีดจำกัดกระแสต่อเนื่องของบอร์ดขับและความร้อนของมอเตอร์ แล้วคำนวณจาก τ_j,max = 0.807 × I_max
6. ศึกษาความไวต่อความตึงเชือก โดยวัด K_t,j ประสิทธิภาพ และแรงบิดฝืนย้อนกลับ ที่ระดับความตึง 2 ถึง 3 ระดับ เพื่อหาจุดที่สมดุลที่สุดระหว่างประสิทธิภาพกับความฝืด
7. นำค่า K_t,j = 0.807 N·m/A ไปใช้ในเฟิร์มแวร์สำหรับแปลงคำสั่งแรงบิดที่ข้อต่อเป็นคำสั่งกระแส และนำอัตราทดกับประสิทธิภาพจริงไปแทนในแบบจำลองพลศาสตร์ของ Disturbance Observer

## บันทึกเพิ่มเติม

ExArMo — Logbook: Capstan Drive Performance Test | หน้า /
