Siwachanat/ExArMo/Logbook_Capstan_Drive_Performance_TH_1.docx

บันทึกการปฏิบัติงานโครงงาน (Project Logbook)

การทดสอบและหาประสิทธิภาพชุดส่งกำลังแคปสแตน

Capstan Drive Performance Test

หัวข้อ | รายละเอียด
โครงงาน | ExArMo — อุปกรณ์ฟื้นฟูข้อศอกแบบสวมใส่ 1 องศาอิสระ (1-DOF Elbow Exoskeleton)
ส่วนของงาน | การทดสอบอัตราทดและประสิทธิภาพของชุดส่งกำลังแคปสแตน
การจัดวาง A | คานยาว 10 cm ต่อกับแกนมอเตอร์โดยตรง (Direct drive)
การจัดวาง B | คานยาว 10 cm ต่อกับดรัมขาออกของชุดแคปสแตน (Through capstan)
วิธีการ | ปรับค่ากระแส I_q เป็นขั้น ๆ แล้ววัดแรงด้วยโหลดเซลล์ (ชุดทดสอบเดียวกับ logbook ค่า K_t วิธีที่ 2)
ชุดส่งกำลัง | Capstan Drive อัตราทดออกแบบ 9 : 1 (ดรัม ⌀11 มม. และ ⌀99 มม., เชือก ⌀2 มม.)
มอเตอร์ | มอเตอร์ที่พันใหม่ 40 รอบ/ฟัน ต่อแบบสตาร์ (K_t = 0.10148 N·m/A)
ผู้บันทึก | .................................................................
วันที่ทดลอง | .................................................................
สถานะ | ☐ ทดลองแล้ว ☐ วิเคราะห์ผลแล้ว ☐ ทดลองซ้ำเพื่อยืนยัน

# 1. วัตถุประสงค์ของการทดลอง

ในสองการทดลองก่อนหน้านี้เราได้พิสูจน์แล้วว่ามอเตอร์ที่พันใหม่ให้ค่าคงตัวแรงบิดตามทฤษฎี และเราได้ออกแบบชุดส่งกำลังแคปสแตนที่มีอัตราทดตามแบบ 9 : 1 การทดลองนี้เป็นขั้นตอนสุดท้ายของการยืนยันสายส่งกำลังทั้งเส้น คือวัดว่าเมื่อประกอบทุกอย่างเข้าด้วยกันแล้ว แรงบิดที่ออกมาที่ข้อต่อจริง ๆ เป็นเท่าไร

- วัด อัตราขยายแรงบิดรวม (i · η) ของชุดแคปสแตนจากการทดลองจริง
- แยกค่า อัตราทดจริง (i) ออกจาก ประสิทธิภาพเชิงกล (η) เพื่อไม่ให้สับสนระหว่างความคลาดเคลื่อนทางเรขาคณิตกับการสูญเสียพลังงาน
- วัด แรงเสียดทานสถิตที่ชุดแคปสแตนเพิ่มเข้ามา ซึ่งเป็นตัวกำหนดว่าผู้ใช้ต้องออกแรงเท่าไรจึงจะเริ่มขยับแขนกลได้
- ยืนยันว่าแรงบิดที่ข้อต่อเพียงพอต่องานกายภาพบำบัดข้อศอกที่ต้องการประมาณ 2 ถึง 3 N·m

แนวคิดหลักของการทดลอง เราวัดสองครั้งด้วยชุดทดสอบเดียวกัน คานยาวเท่ากัน และโหลดเซลล์ตัวเดียวกัน ต่างกันแค่ว่าคานติดอยู่กับแกนมอเตอร์โดยตรง หรือติดอยู่กับดรัมขาออกของแคปสแตน แล้วนำผลทั้งสองมาหารกัน วิธีนี้ทำให้ความคลาดเคลื่อนที่เหมือนกันทั้งสองครั้งหักล้างกันหมด ซึ่งเป็นจุดแข็งที่สุดของการออกแบบการทดลองนี้ (ดูข้อ 2.2)

# 2. ทฤษฎี

## 2.1 สมการพื้นฐานของชุดส่งกำลัง

ชุดส่งกำลังที่มีอัตราทด i และประสิทธิภาพเชิงกล η จะแปลงแรงบิดขาเข้าเป็นแรงบิดขาออกตามสมการ

τ_out = i · η · τ_in ω_out = ω_in / i

เมื่อรวมกับความสัมพันธ์ระหว่างแรงบิดกับกระแสของมอเตอร์ที่เราหาไว้แล้วในการทดลองค่า K_t จะได้

การจัดวาง A : τ_A = K_t · I_q + b_A

การจัดวาง B : τ_B = ( i · η · K_t ) · I_q + b_B

ดังนั้นถ้าเราพล็อตแรงบิดที่วัดได้เทียบกับกระแสในทั้งสองการจัดวาง แล้วหาความชันของแต่ละเส้น ความชันของเส้น B จะมากกว่าความชันของเส้น A อยู่เท่ากับ i · η พอดี

i · η = ความชัน_B / ความชัน_A

## 2.2 ทำไมการวัดแบบเทียบสองการจัดวางจึงแม่นยำเป็นพิเศษ

จุดแข็งของวิธีนี้อยู่ที่การนำผลสองชุดมาหารกัน เพราะความคลาดเคลื่อนที่ปรากฏเหมือนกันในทั้งสองการวัดจะถูกหักล้างไปหมด

แหล่งความคลาดเคลื่อน | มีผลต่อการวัดเดี่ยว | มีผลต่ออัตราส่วน B ÷ A
ค่าตัวคูณของโหลดเซลล์ | มีผลเต็มที่ | หักล้างหมด (ใช้เซลล์ตัวเดียวกัน)
ระยะแขน r ของคาน | มีผลเต็มที่ | หักล้างหมด (ใช้คานเดียวกัน)
ค่า K_t ของมอเตอร์ | มีผลเต็มที่ | หักล้างหมด (มอเตอร์ตัวเดียวกัน)
ความคลาดเคลื่อนของค่ากระแส I_q ที่รายงาน | มีผลเต็มที่ | หักล้างหมด
ความตั้งฉากของแรงที่กระทำต่อโหลดเซลล์ | มีผลเต็มที่ | หักล้างบางส่วน ถ้าจัดวางเหมือนกัน

เงื่อนไขสำคัญ ประโยชน์ข้อนี้จะเกิดขึ้นก็ต่อเมื่อใช้ โหลดเซลล์ตัวเดียวกัน คานความยาวเท่ากัน และมอเตอร์ตัวเดียวกัน ในทั้งสองการจัดวาง ถ้าเปลี่ยนโหลดเซลล์เพราะพิกัดไม่พอ ความคลาดเคลื่อนจะไม่หักล้างกันอีกต่อไป และต้องสอบเทียบเซลล์ทั้งสองตัวด้วยตุ้มน้ำหนักมาตรฐานชุดเดียวกันแทน

## 2.3 การแยกอัตราทดจริงออกจากประสิทธิภาพ

การทดลองนี้วัดได้โดยตรงเพียงผลคูณ i · η เท่านั้น ไม่สามารถแยกสองตัวนี้ออกจากกันได้ด้วยตัวมันเอง จึงต้องหาค่า i จากแหล่งอื่นก่อน

วิธีหาค่า i | วิธีทำ | ข้อจำกัด
จากแบบทางเรขาคณิต | i = D₂ / D₁ = 99 / 11 = 9.00 | ถ้าร่องเชือกลึกไม่ตรงตามแบบ ค่าจริงจะเพี้ยน
วัดจากเอนโคดเดอร์ (แนะนำ) | หมุนขาออกไปหนึ่งช่วงมุมที่ทราบ แล้วนับมุมที่แกนมอเตอร์หมุนไป i = Δθ_มอเตอร์ / Δθ_ขาออก | ต้องมีเอนโคดเดอร์ทั้งสองฝั่ง หรือวัดมุมขาออกด้วยเครื่องมือ

ทำไมต้องวัด i แยกต่างหาก ใน logbook การออกแบบแคปสแตนเราพบว่า ถ้าร่องเชือกไม่ได้ลึกครึ่งหนึ่งของเส้นผ่านศูนย์กลางเชือก แนวศูนย์กลางเชือกจะเลื่อนไปอยู่ที่ ⌀13 และ ⌀101 ทำให้อัตราทดจริงเหลือเพียง 7.77 แทนที่จะเป็น 9.00 ถ้าเราเหมาเอาว่า i = 9 เสมอ ความคลาดเคลื่อนทางเรขาคณิตนี้จะไปโผล่เป็นค่า η ที่ต่ำผิดปกติ ทำให้สรุปผิดว่าชุดส่งกำลังมีประสิทธิภาพแย่ ทั้งที่จริงแล้วปัญหาอยู่ที่ขนาดของร่อง

เกณฑ์ตรวจสอบง่าย ๆ: ถ้าค่า i · η ที่วัดได้ มากกว่า 9 แสดงว่าอัตราทดจริงต้องมากกว่า 9 แน่นอน เพราะประสิทธิภาพเป็นไปไม่ได้ที่จะเกิน 100 % ในกรณีนั้นให้กลับไปวัดขนาดดรัมและความลึกร่องใหม่

## 2.4 ความหมายของความชันกับจุดตัดแกน

เช่นเดียวกับการทดลองหาค่า K_t เส้นตรงที่ได้จากการทดลองนี้มีสองส่วนที่มีความหมายทางกายภาพต่างกัน และต้องตีความแยกกัน

ส่วนของเส้นตรง | ความหมายทางกายภาพ | สิ่งที่บอกเราได้
ความชัน | การสูญเสียที่แปรผันตามภาระ เช่น ความฝืดของแบริ่งที่เพิ่มตามแรงตึงเชือก และการสูญเสียภายในเนื้อเชือก | ค่า i · η ที่ใช้คำนวณประสิทธิภาพ
จุดตัดแกน b | แรงบิดที่ระบบต้านได้เองโดยไม่ต้องใช้กระแส คือ cogging torque บวกแรงเสียดทานสถิตของแบริ่งและเชือก | แรงที่ผู้ใช้ต้องออกก่อนแขนกลจะเริ่มขยับ (สำคัญมากต่อความรู้สึกในการใช้งาน)

แรงเสียดทานที่ชุดแคปสแตนเพิ่มเข้ามาเอง หาได้จากการเทียบจุดตัดแกนของทั้งสองการจัดวาง โดยต้องแปลงจุดตัดแกนของการจัดวาง A ให้ไปอยู่ที่ฝั่งขาออกก่อน

τ_เสียดทาน,แคปสแตน = b_B − ( i · η ) · b_A

ค่านี้บอกโดยตรงว่าถ้าผู้ใช้จับแขนกลแล้วออกแรงหมุน จะต้องออกแรงบิดอย่างน้อยเท่าไรจึงจะเอาชนะความฝืดของระบบได้ ซึ่งเป็นตัวเลขที่ใช้ตัดสินคุณสมบัติ Backdrivability ได้ตรงที่สุด

## 2.5 ประสิทธิภาพขึ้นกับจุดทำงาน

เนื่องจากมีทั้งส่วนที่แปรผันตามภาระและส่วนที่คงที่ ประสิทธิภาพโดยรวมจึงไม่ใช่ตัวเลขตัวเดียว แต่เปลี่ยนไปตามแรงบิดที่ใช้งาน

η(I_q) = ( ความชัน_B · I_q + b_B ) / [ i · ( ความชัน_A · I_q + b_A ) ]

- ที่แรงบิดต่ำ ค่า b ครองสัดส่วนใหญ่ ประสิทธิภาพจึงต่ำ
- ที่แรงบิดสูง ผลของ b เจือจางลง ประสิทธิภาพจึงเข้าใกล้ค่าที่ได้จากอัตราส่วนความชัน
- เวลารายงานค่าประสิทธิภาพต้องระบุเสมอว่าเป็นค่าที่จุดทำงานใด มิฉะนั้นตัวเลขจะเทียบกันไม่ได้

## 2.6 ค่าที่คาดการณ์ไว้ล่วงหน้า

จากค่า K_t = 0.10148 N·m/A ที่วัดได้ในการทดลองก่อนหน้า และอัตราทดออกแบบ 9 : 1 เราคาดว่าจะได้ค่าดังตาราง

สมมติฐาน | ความชัน B (N·m/A) | แรงบิดที่ I_q = 4 A | แรงที่คาน 10 cm
η = 1.00 (ไม่มีการสูญเสีย) | 0.9133 | 3.65 N·m | 36.5 N (3.7 kg)
η = 0.90 | 0.8220 | 3.29 N·m | 32.9 N (3.4 kg)
η = 0.87 | 0.7946 | 3.18 N·m | 31.8 N (3.2 kg)
η = 0.80 | 0.7307 | 2.92 N·m | 29.2 N (3.0 kg)

ส่วนการจัดวาง A ที่กระแสเดียวกัน 4 A จะได้แรงบิด 0.406 N·m คิดเป็นแรงที่คานเพียง 4.06 N หรือประมาณ 414 กรัม

[ วางรูปที่นี่ / Insert image here ]

แผนภาพหลักการทดลอง — เปรียบเทียบการจัดวาง A (ต่อแกนมอเตอร์ตรง) กับ B (ผ่านชุดแคปสแตน)

รูปที่ 1 แผนภาพหลักการทดลอง — เปรียบเทียบการจัดวาง A (ต่อแกนมอเตอร์ตรง) กับ B (ผ่านชุดแคปสแตน)

# 3. เทคนิคและวิธีการทดลอง

## 3.1 ชุดทดสอบ

ใช้ชุดทดสอบเดียวกับที่พัฒนาไว้ในการวัดค่า K_t วิธีที่ 2 คือโหลดเซลล์ต่อกับบอร์ด Arduino ส่งค่าเข้าโปรแกรม Python GUI พร้อมกับค่ากระแส I_q จากเฟิร์มแวร์ SimpleFOC แล้วบันทึกทั้งสองค่าพร้อมเวลาลงไฟล์ CSV

รายการ | การจัดวาง A (Direct) | การจัดวาง B (Through capstan)
คานติดที่ไหน | แกนมอเตอร์โดยตรง | ดรัมขาออก ⌀99 มม. ของแคปสแตน
ความยาวคาน | 10 cm | 10 cm (คานเดียวกัน)
โหลดเซลล์ | ตัวเดียวกัน | ตัวเดียวกัน
สิ่งที่วัดได้ | K_t ของมอเตอร์ | K_t × i × η ที่ข้อต่อ
ช่วงแรงที่คาดว่าจะเจอ | 0 ถึงประมาณ 4 N | 0 ถึงประมาณ 37 N

## 3.2 การเลือกพิกัดของโหลดเซลล์

นี่คือประเด็นที่ต้องวางแผนก่อนเริ่มทดลอง เพราะแรงที่เกิดขึ้นในสองการจัดวางต่างกันเกือบสิบเท่า

- ถ้าใช้โหลดเซลล์ตัวเดียวกันทั้งสองการจัดวาง ความคลาดเคลื่อนจะหักล้างกันตามข้อ 2.2 ซึ่งเป็นข้อดีที่สำคัญมาก แต่ต้องเลือกพิกัดให้ครอบคลุมแรงสูงสุดของการจัดวาง B คือประมาณ 5 กิโลกรัม และในการจัดวาง A เราจะใช้เพียงราว 8 % ของพิกัดเท่านั้น
- ข้อควรระวัง: ความแม่นยำของโหลดเซลล์มักระบุเป็นเปอร์เซ็นต์ของพิกัดเต็ม ดังนั้นการวัดที่เพียง 8 % ของพิกัดจะมีความคลาดเคลื่อนสัมพัทธ์สูงกว่าปกติราวสิบเท่า ต้องเก็บจุดข้อมูลให้มากเพื่อชดเชยด้วยการเฉลี่ยทางสถิติ
- ทางเลือก: ถ้าจำเป็นต้องใช้โหลดเซลล์คนละตัว ต้องสอบเทียบทั้งสองตัวด้วยตุ้มน้ำหนักมาตรฐานชุดเดียวกัน และต้องรายงานความไม่แน่นอนของการสอบเทียบเข้าไปในผลด้วย เพราะข้อดีเรื่องการหักล้างความคลาดเคลื่อนหายไปแล้ว

## 3.3 ขั้นตอนการทดลอง

1. วัดอัตราทดจริง i ก่อนเป็นอันดับแรก โดยหมุนดรัมขาออกไปหนึ่งช่วงมุมที่ทราบค่า แล้วอ่านมุมที่แกนมอเตอร์หมุนไปจากเอนโคดเดอร์ ทำซ้ำหลายครั้งแล้วเฉลี่ย
2. ตั้งความตึงเชือกให้ได้ตามที่กำหนด แล้วบันทึกวิธีตั้งไว้ให้ชัดเจน เพราะความตึงมีผลต่อทั้งความฝืดและความแข็งของระบบ
3. ประกอบการจัดวาง A ติดคานเข้ากับแกนมอเตอร์ จัดให้คานอยู่แนวระนาบและกดตรงแกนวัดของโหลดเซลล์
4. ตั้งศูนย์โหลดเซลล์ขณะยังไม่จ่ายกระแส แล้วตั้งเฟิร์มแวร์เป็นโหมดแรงบิดพร้อมจำกัดกระแสสูงสุด
5. แรมป์ค่า I_q ขึ้นทีละขั้นอย่างช้า ๆ จนถึงค่าสูงสุดที่กำหนด แล้วลดกลับลงมาที่ศูนย์ตามเส้นทางเดิม บันทึกลง CSV
6. ถอดคานออก ประกอบชุดแคปสแตน แล้วติดคานตัวเดิมเข้ากับดรัมขาออก จัดวางให้เหมือนเดิมทุกประการ
7. ทำซ้ำขั้นตอนที่ 4 และ 5 สำหรับการจัดวาง B
8. ทำซ้ำทั้งชุดในทิศทางการหมุนตรงข้าม เพราะชุดแคปสแตนอาจมีความฝืดไม่เท่ากันในสองทิศทาง
9. นำไฟล์ CSV มาฟิตเส้นตรงแบบมีจุดตัดแกน หาความชันและจุดตัดแกนของแต่ละการจัดวาง แล้วคำนวณตามสมการในข้อ 2

## 3.4 เทคนิคที่ทำให้ผลการวัดเชื่อถือได้

- ใช้คานตัวเดิมและโหลดเซลล์ตัวเดิม และอย่าเปลี่ยนจุดยึดหรือระยะ r ระหว่างสองการจัดวาง นี่คือเงื่อนไขที่ทำให้ความคลาดเคลื่อนหักล้างกัน
- วัดทั้งสองการจัดวางในวันเดียวกัน เพราะอุณหภูมิมีผลต่อทั้งค่า K_t ของมอเตอร์และการดริฟต์ของโหลดเซลล์
- ดึงเชือกทิ้งไว้ก่อนติดตั้ง (Pre-stretch) และตั้งความตึงใหม่ก่อนเริ่ม เพราะเชือกที่ยังไม่ผ่านการยืดตัวจะคลายตัวระหว่างทดลอง ทำให้ความชันไหลลง
- วัดซ้ำที่หลายตำแหน่งเชิงมุมของดรัม เพราะทั้ง cogging torque ของมอเตอร์และตำแหน่งของเชือกบนร่องเปลี่ยนไปตามมุม
- เก็บทั้งขาขึ้นและขาลง ผลต่างระหว่างสองขาคือขนาดของฮิสเทอรีซิสจากแรงเสียดทาน ซึ่งเป็นข้อมูลที่มีค่าในตัวเอง
- ตรวจว่าเชือกไม่ลื่นระหว่างการทดลอง โดยทำเครื่องหมายที่เชือกกับดรัม หรือเทียบมุมมอเตอร์กับมุมขาออกก่อนและหลังทดลอง ถ้าเลื่อนแสดงว่าเชือกลื่นและข้อมูลชุดนั้นใช้ไม่ได้
- ตรวจความแข็งแรงของโครงยึด ที่การจัดวาง B แรงที่เกิดขึ้นสูงถึงเกือบ 40 N ถ้าโครงยึดโก่งตัว มุมของคานจะเปลี่ยนและค่าที่วัดได้จะต่ำกว่าความจริง

[ วางรูปที่นี่ / Insert image here ]

ชุดทดสอบจริง — การจัดวาง A ต่อคานเข้ากับแกนมอเตอร์โดยตรง

รูปที่ 2 ชุดทดสอบจริง — การจัดวาง A ต่อคานเข้ากับแกนมอเตอร์โดยตรง

[ วางรูปที่นี่ / Insert image here ]

ชุดทดสอบจริง — การจัดวาง B ต่อคานเข้ากับดรัมขาออกของชุดแคปสแตน

รูปที่ 3 ชุดทดสอบจริง — การจัดวาง B ต่อคานเข้ากับดรัมขาออกของชุดแคปสแตน

# 4. ผลการทดลอง

ตารางในหัวข้อนี้เว้นไว้สำหรับกรอกค่าที่ได้จากการประมวลผลไฟล์ CSV ของการทดลองจริง

## 4.1 อัตราทดจริงที่วัดได้

รายการ | ครั้งที่ 1 | ครั้งที่ 2 | ครั้งที่ 3
มุมที่ดรัมขาออกหมุนไป (°) | ..................... | ..................... | .....................
มุมที่แกนมอเตอร์หมุนไป (°) | ..................... | ..................... | .....................
อัตราทด i ที่คำนวณได้ | ..................... | ..................... | .....................

ค่าเฉลี่ยของอัตราทดจริง i = ..................... (ค่าออกแบบคือ 9.00)

## 4.2 ผลการฟิตเส้นตรงของทั้งสองการจัดวาง

รายการ | A (Direct) | B (Through capstan) | หมายเหตุ
จำนวนจุดข้อมูลที่ใช้ฟิต | ..................... | ..................... | หลังกรองช่วงที่นิ่ง
ช่วงกระแสที่ทดสอบ (A) | ..................... | ..................... | ควรทับซ้อนกัน
ความชัน ขาขึ้น (N·m/A) | ..................... | .....................
ความชัน ขาลง (N·m/A) | ..................... | .....................
ความชัน เฉลี่ย (N·m/A) | ..................... | ..................... | ค่าที่นำไปคำนวณ
จุดตัดแกน b (N·m) | ..................... | ..................... | cogging + เสียดทาน
R² ของการฟิต | ..................... | ..................... | ควรมากกว่า 0.99

## 4.3 การคำนวณผลลัพธ์

1) อัตราขยายแรงบิดรวม

i * eta = slope_B / slope_A = ........... / ........... = ...........

2) ประสิทธิภาพเชิงกล (ใช้ค่า i ที่วัดได้จากข้อ 4.1)

eta = (i * eta) / i = ........... / ........... = ........... = ......... %

3) แรงเสียดทานที่ชุดแคปสแตนเพิ่มเข้ามา (อ้างอิงที่ฝั่งขาออก)

tau_friction = b_B - (i * eta) * b_A

= ........... - ........... * ........... = ........... N*m

4) แรงบิดสูงสุดที่ข้อต่อ ที่กระแสสูงสุดที่ใช้งาน

tau_out_max = slope_B * Iq_max + b_B = ........... N*m

ผลลัพธ์ | ค่าที่ได้ | เกณฑ์ / ค่าอ้างอิง
อัตราขยายแรงบิดรวม i · η | ..................... | ต้องน้อยกว่า i เสมอ
อัตราทดจริง i | ..................... | ค่าออกแบบ 9.00
ประสิทธิภาพเชิงกล η | ..................... | เป้าหมาย ≥ 85 %
แรงเสียดทานของแคปสแตน (ที่ขาออก) | ..................... | ยิ่งต่ำยิ่งดี ต่อ Backdrivability
ฮิสเทอรีซิส (ขาขึ้น − ขาลง) | ..................... | บ่งบอกแรงเสียดทาน
แรงบิดสูงสุดที่ข้อต่อ | ..................... | ต้องได้อย่างน้อย 2–3 N·m

สิ่งที่ต้องตรวจก่อนสรุป ค่า i · η ที่วัดได้ต้องน้อยกว่าอัตราทดจริง i เสมอ ถ้าออกมามากกว่า แสดงว่าอัตราทดจริงสูงกว่าที่คิด หรือมีความผิดพลาดในการวัด เพราะประสิทธิภาพเกิน 100 % เป็นไปไม่ได้

## 4.4 ประสิทธิภาพที่จุดทำงานต่าง ๆ

คำนวณจากสมการในข้อ 2.5 เพื่อแสดงว่าประสิทธิภาพไม่ใช่ตัวเลขเดียว แต่ขึ้นกับแรงบิดที่ใช้งาน

กระแส I_q (A) | แรงบิดที่ขาออก (N·m) | ประสิทธิภาพ η (%) | หมายเหตุ
1 | ..................... | ..................... | ภาระเบา
2 | ..................... | .....................
3 | ..................... | .....................
4 | ..................... | ..................... | จุดทำงานหลัก

[ วางรูปที่นี่ / Insert image here ]

กราฟเปรียบเทียบแรงบิดเทียบกระแส ระหว่างการจัดวาง A และ B แสดงความชันที่ต่างกัน

รูปที่ 4 กราฟเปรียบเทียบแรงบิดเทียบกระแส ระหว่างการจัดวาง A และ B แสดงความชันที่ต่างกัน

[ วางรูปที่นี่ / Insert image here ]

กราฟประสิทธิภาพเทียบกับแรงบิดที่ขาออก

รูปที่ 5 กราฟประสิทธิภาพเทียบกับแรงบิดที่ขาออก

# 5. ปัญหาที่พบและแนวทางแก้ไข

## 5.1 ปัญหาด้านชุดส่งกำลังแคปสแตน

ปัญหาที่พบ | สาเหตุ | วิธีแก้
ค่า i · η ที่วัดได้ต่ำกว่าที่คาดมาก | อัตราทดจริงไม่ถึง 9 เพราะร่องเชือกลึกไม่ตรงตามแบบ ทำให้แนวศูนย์กลางเชือกเลื่อน | วัดอัตราทดจริงด้วยเอนโคดเดอร์ก่อนเสมอ อย่าเหมาว่าเท่ากับค่าออกแบบ แล้วตรวจความลึกร่องด้วย Section Analysis
ความชันไหลลงเรื่อย ๆ ระหว่างการทดลอง | เชือกยืดตัว (Creep) โดยเฉพาะช่วงการใช้งานแรก ๆ ทำให้ความตึงลดลง | ดึงเชือกทิ้งไว้ก่อนติดตั้ง และตั้งความตึงใหม่ก่อนเริ่มทุกชุดการทดลอง
ค่าที่วัดได้กระโดดลงทันทีแล้วไม่กลับ | เชือกลื่นบนดรัมเล็ก เพราะรอบพันน้อยเกินไปหรือความตึงเริ่มต้นต่ำ | เพิ่มรอบตายเป็น 2 ถึง 3 รอบ ทำเครื่องหมายที่เชือกเพื่อตรวจการลื่น และทิ้งข้อมูลชุดที่ลื่น
ค่าที่ได้ในสองทิศทางไม่เท่ากัน | เส้นทางเดินเชือกและจุดยึดไม่สมมาตร ทำให้แรงกดแบริ่งต่างกัน | รายงานแยกทั้งสองทิศทาง และปรับการเดินเชือกให้สมมาตรถ้าทำได้
จุดตัดแกน b_B สูงมากจนแขนกลฝืด | แรงเสียดทานสถิตของแคปสแตนสูง มักมาจากความตึงเชือกมากเกินไป หรือร่องหยาบ | ลดความตึงลงเท่าที่ยังไม่ลื่น ขัดร่องให้เรียบ และตรวจการจัดศูนย์ของแบริ่ง
ผลไม่นิ่งเมื่อวัดที่มุมต่างกัน | ตำแหน่งเชือกบนร่องและ cogging torque เปลี่ยนตามมุม | วัดหลายมุมแล้วรายงานค่าเฉลี่ยพร้อมช่วงการกระจาย

## 5.2 ปัญหาด้านชุดทดสอบและการวัด

ปัญหาที่พบ | สาเหตุ | วิธีแก้
แรงในการจัดวาง B สูงเกินพิกัดโหลดเซลล์ | แรงบิดที่ขาออกสูงกว่าเกือบ 10 เท่า แต่ใช้คานยาวเท่าเดิม | เลือกโหลดเซลล์พิกัดอย่างน้อย 5 กิโลกรัม ตั้งแต่แรก และจำกัดกระแสสูงสุดในเฟิร์มแวร์ก่อนเริ่ม
ข้อมูลของการจัดวาง A มีสัญญาณรบกวนสูงกว่า | ใช้เพียงราว 8 % ของพิกัดโหลดเซลล์ ในขณะที่ความแม่นยำระบุเป็นเปอร์เซ็นต์ของพิกัดเต็ม | เก็บจุดข้อมูลให้มากขึ้นเพื่อเฉลี่ยทางสถิติ และรายงานความไม่แน่นอนของทั้งสองการจัดวางแยกกัน
เปลี่ยนโหลดเซลล์ระหว่างสองการจัดวาง | ความคลาดเคลื่อนไม่หักล้างกันอีกต่อไป ค่าที่ได้จึงเชื่อถือได้น้อยลง | ใช้เซลล์ตัวเดียวกันถ้าทำได้ ถ้าจำเป็นต้องเปลี่ยนให้สอบเทียบทั้งสองตัวด้วยตุ้มมาตรฐานชุดเดียวกัน
ระยะ r ของสองการจัดวางไม่เท่ากันจริง | จุดยึดคานบนดรัมขาออกกับบนแกนมอเตอร์อยู่คนละตำแหน่ง | ใช้คานตัวเดียวกันและวัดระยะจากแกนหมุนถึงจุดสัมผัสด้วยเวอร์เนียทั้งสองครั้ง
โครงยึดโก่งตัวที่แรงสูง | แรงเกือบ 40 N ทำให้โครงเสียรูป มุมคานเปลี่ยน ค่าที่วัดได้ต่ำกว่าจริง | เสริมความแข็งแรงของโครงยึด และตรวจด้วยการวางไดอัลเกจดูการขยับที่จุดยึด
คานไม่ตั้งฉากกับแกนวัดของโหลดเซลล์ | แรงที่วัดได้เป็นเพียงองค์ประกอบตามแกน ทำให้ต่ำกว่าจริง | จัดวางให้ตั้งฉากทั้งสองการจัดวาง และใช้จุดสัมผัสแบบปลายมนเพื่อไม่ให้เกิดแรงด้านข้าง
ค่าแรงกับค่า I_q ไม่ตรงเวลากัน | ข้อมูลมาจากพอร์ตอนุกรมคนละพอร์ต | ประทับเวลาที่ต้นทางทั้งสองฝั่ง แล้วจัดให้อยู่บนฐานเวลาเดียวกันก่อนฟิต

## 5.3 ข้อควรระวังในการตีความ

- ค่าที่วัดได้เป็นประสิทธิภาพในสภาวะสถิต ซึ่งไม่ครอบคลุมการสูญเสียที่เกิดจากการเคลื่อนที่ เช่น การเสียดสีของเชือกขณะม้วนเข้าและคลายออก ประสิทธิภาพขณะเคลื่อนที่จริงมักต่ำกว่าค่าที่วัดได้แบบสถิตเล็กน้อย
- ต้องระบุจุดทำงานเสมอ เพราะประสิทธิภาพเปลี่ยนตามแรงบิด การรายงานเป็นตัวเลขเดียวโดยไม่บอกว่าวัดที่กระแสเท่าไรทำให้เทียบกันไม่ได้
- ค่า i · η ไม่ใช่ประสิทธิภาพ ต้องหารด้วยอัตราทดจริงที่วัดได้ก่อน ไม่ใช่หารด้วยค่าออกแบบ
- จุดตัดแกน b_B มีความสำคัญเทียบเท่าความชัน เพราะมันคือแรงที่ผู้ใช้ต้องเอาชนะก่อนแขนกลจะเริ่มขยับ ซึ่งเป็นตัวชี้วัด Backdrivability โดยตรง ระบบที่มีประสิทธิภาพสูงแต่ฝืดตอนเริ่มต้นก็ยังไม่เหมาะกับงานกายภาพบำบัด

# 6. สรุปและงานถัดไป

การทดลองนี้เป็นการปิดวงจรการตรวจสอบสายส่งกำลังทั้งเส้น ตั้งแต่กระแสที่ไดรเวอร์จ่าย ผ่านมอเตอร์ที่พันใหม่ ผ่านชุดแคปสแตน จนถึงแรงบิดที่ข้อต่อจริง โดยใช้การวัดเชิงเปรียบเทียบที่ทำให้ความคลาดเคลื่อนส่วนใหญ่หักล้างกันเอง

บทเรียนเชิงวิธีการที่สำคัญที่สุดคือ ต้องแยกอัตราทดจริงออกจากประสิทธิภาพให้ได้ก่อน เพราะถ้าเหมาว่าอัตราทดเท่ากับค่าออกแบบ ความคลาดเคลื่อนทางเรขาคณิตจะไปปรากฏเป็นประสิทธิภาพที่ต่ำผิดปกติ และนำไปสู่การแก้ปัญหาผิดจุด

งานถัดไปที่ต้องดำเนินการ:

1. วัดประสิทธิภาพขณะเคลื่อนที่จริง โดยให้ขาออกหมุนด้วยความเร็วคงที่แล้ววัดแรงบิดและกระแส เพื่อเทียบกับค่าที่ได้จากการวัดแบบสถิต
2. วัดแรงบิดที่ต้องใช้ในการฝืนย้อนกลับ (Backdrive torque) ที่ข้อต่อโดยตรง เพื่อยืนยันคุณสมบัติด้านความปลอดภัย
3. วัดระยะฟรี (Backlash) และความแข็งเชิงบิด (Torsional stiffness) ของชุดส่งกำลัง โดยใช้เอนโคดเดอร์ทั้งสองฝั่งขณะเพิ่มภาระ
4. ทดสอบซ้ำหลังการใช้งานต่อเนื่องเป็นเวลานาน เพื่อดูผลของการยืดตัวของเชือกและการสึกของร่องต่อประสิทธิภาพ
5. ทดลองปรับความตึงเชือกหลายระดับ แล้วพล็อตความสัมพันธ์ระหว่างความตึงกับประสิทธิภาพและแรงเสียดทานสถิต เพื่อหาจุดที่เหมาะสมที่สุด
6. นำค่าอัตราทดจริงและประสิทธิภาพที่ได้ ไปแทนในแบบจำลองพลศาสตร์ของ Disturbance Observer และในสูตรแปลงคำสั่งแรงบิดของเฟิร์มแวร์

## บันทึกเพิ่มเติม

ExArMo — Logbook: Capstan Drive Performance Test | หน้า /
