Siwachanat/ExArMo/Logbook_Motor_Kv_Measurement_TH.docx

บันทึกการปฏิบัติงานโครงงาน (Project Logbook)

การวัดและเปรียบเทียบค่าคงตัวความเร็วของมอเตอร์

Motor Velocity Constant (Kv) Measurement

หัวข้อ | รายละเอียด
โครงงาน | ExArMo — อุปกรณ์ฟื้นฟูข้อศอกแบบสวมใส่ 1 องศาอิสระ (1-DOF Elbow Exoskeleton)
ส่วนของงาน | การวัดและเปรียบเทียบค่าคงตัวความเร็ว (K_v) ก่อน–หลังการพันขดลวดใหม่
ชิ้นงานทดสอบ A | มอเตอร์เดิมจากโรงงาน 5008 335KV — พันแบบเดลต้า 20 รอบ/ฟัน
ชิ้นงานทดสอบ B | มอเตอร์ที่พันใหม่ — 40 รอบ/ฟัน ต่อแบบสตาร์
วิธีการ | ต่อมอเตอร์สองตัวประกบหน้าชนหน้า ตัวหนึ่งเป็นต้นกำลัง อีกตัวทำหน้าที่เป็นเครื่องกำเนิดไฟฟ้า
ระดับกำลังที่ทดสอบ | 50 %, 75 % และ 100 %
เครื่องมือวัด | ดิจิทัลแทโคมิเตอร์ (วัดความเร็วรอบ) และมัลติมิเตอร์ย่านไฟฟ้ากระแสสลับ (วัด V_rms)
ผู้บันทึก | .................................................................
วันที่ทดลอง | .................................................................
สถานะ | ☑ ทดลองแล้ว ☑ วิเคราะห์ผลแล้ว ☐ ยืนยันนิยามแรงดันด้วยออสซิลโลสโคป

# 1. วัตถุประสงค์ของการทดลอง

ในการทดลองหาค่า K_t เราได้ยืนยันแล้วว่าแรงบิดต่อกระแสเพิ่มขึ้นตามทฤษฎี แต่ค่า K_t นั้นได้มาจากการวัดแรงบิด ซึ่งมีทั้งแรงเสียดทานและ cogging torque ปะปนอยู่ การทดลองนี้จึงเป็นการตรวจสอบด้วยวิธีที่เป็นอิสระอย่างสิ้นเชิง คือวัดจากแรงเคลื่อนไฟฟ้าย้อนกลับ ซึ่งไม่ได้รับผลจากแรงเสียดทานเลย

- หาค่า K_v (ค่าคงตัวความเร็ว, RPM/V) ของมอเตอร์ทั้งสองตัวจากการทดลองจริง
- ตรวจสอบว่าค่า K_v ลดลงเป็น 2√3 ≈ 3.46 เท่า ตามที่ทฤษฎีทำนายไว้
- ตรวจสอบไขว้กับค่า K_t ที่วัดได้ก่อนหน้า ผ่านความสัมพันธ์ K_t = 9.549 / K_v
- ยืนยันว่าจำนวนรอบและวิธีต่อปลายขดลวดถูกต้องตามที่ตั้งใจไว้

ทำไมการวัด K_v จึงสำคัญเป็นพิเศษ ค่าความต้านทานขดลวดบอกได้แค่ปริมาณทองแดง ส่วนค่า K_t ก็ปะปนกับแรงเสียดทาน แต่แรงเคลื่อนไฟฟ้าย้อนกลับขึ้นอยู่กับจำนวนรอบ ความเข้มสนามแม่เหล็ก และวิธีต่อปลายขดลวดเท่านั้น ไม่ขึ้นกับขนาดลวดและไม่ขึ้นกับแรงเสียดทานใด ๆ การวัด K_v จึงเป็นการยืนยันจำนวนรอบและวิธีต่อที่ตรงที่สุดในบรรดาการทดลองทั้งสามแบบ

# 2. ทฤษฎี

## 2.1 ค่าคงตัวความเร็วคืออะไร

เมื่อโรเตอร์ของมอเตอร์หมุน สนามแม่เหล็กที่เคลื่อนที่ผ่านขดลวดจะเหนี่ยวนำให้เกิดแรงเคลื่อนไฟฟ้าขึ้นในขดลวด เรียกว่าแรงเคลื่อนไฟฟ้าย้อนกลับ (Back-EMF) ซึ่งแปรผันตรงกับความเร็วเชิงมุม

e = K_e · ω

K_e คือค่าคงตัวแรงเคลื่อนไฟฟ้า มีหน่วย V·s/rad ส่วนค่า K_v ที่นิยมระบุในสเปกของมอเตอร์คือส่วนกลับของค่านี้ในหน่วยที่ใช้งานง่ายกว่า คือรอบต่อนาทีต่อโวลต์

K_v [RPM/V] = ความเร็วรอบ / แรงดันที่วัดได้

ในทางปฏิบัติหมายความว่า ถ้าจ่ายไฟหนึ่งโวลต์ให้มอเตอร์โดยไม่มีภาระ มอเตอร์จะหมุนได้กี่รอบต่อนาที มอเตอร์ที่มีค่า K_v สูงจึงหมุนเร็วแต่แรงบิดต่ำ ส่วนมอเตอร์ที่มีค่า K_v ต่ำจะหมุนช้าแต่แรงบิดสูง

## 2.2 ความสัมพันธ์ระหว่าง K_v กับ K_t

ในระบบหน่วย SI ค่าคงตัวแรงเคลื่อนไฟฟ้ากับค่าคงตัวแรงบิดมีค่าเท่ากันพอดี ซึ่งเป็นผลโดยตรงจากกฎการอนุรักษ์พลังงาน เพราะกำลังไฟฟ้าที่ป้อนเข้าเท่ากับกำลังกลที่ได้ออกมาในอุดมคติ

K_t [N·m/A] = K_e [V·s/rad] = 60 / ( 2π · K_v ) ≈ 9.549 / K_v [RPM/V]

ความสัมพันธ์นี้ทำให้เราตรวจสอบผลของสองการทดลองไขว้กันได้ ถ้าค่าที่ได้จากทั้งสองวิธีสอดคล้องกัน แสดงว่าทั้งชุดทดสอบและความเข้าใจทางทฤษฎีของเราถูกต้อง

## 2.3 ทำไม K_v จึงต้องลดลง 2√3 เท่า

ปัจจัย | ผลต่อ K_e และ K_t | ผลต่อ K_v
จำนวนรอบเพิ่มจาก 20 เป็น 40 | × 2 | ÷ 2
เปลี่ยนจากเดลต้าเป็นสตาร์ | × √3 ≈ 1.732 | ÷ 1.732
รวมทั้งสองปัจจัย | × 2√3 ≈ 3.464 | ÷ 3.464

เหตุผลของแต่ละปัจจัย

- จำนวนรอบ: แรงเคลื่อนไฟฟ้าเหนี่ยวนำในขดลวดแปรผันตรงกับจำนวนรอบ พันเป็นสองเท่าจึงได้แรงดันเป็นสองเท่าที่ความเร็วเดิม ค่า K_v จึงลดลงครึ่งหนึ่ง
- การต่อแบบสตาร์: แรงดันระหว่างขั้วสองขั้วของการต่อแบบสตาร์เป็น √3 เท่าของแรงดันต่อเฟส ในขณะที่การต่อแบบเดลต้า แรงดันระหว่างขั้วเท่ากับแรงดันต่อเฟสพอดี การเปลี่ยนจากเดลต้าเป็นสตาร์จึงได้แรงดันที่ขั้วเพิ่มขึ้น √3 เท่าที่ความเร็วเดิม

## 2.4 นิยามของแรงดันที่ใช้ — ประเด็นที่ต้องระวังที่สุด

ค่า K_v ไม่ใช่ปริมาณที่มีนิยามเดียว แต่ขึ้นอยู่กับว่าเราวัดแรงดันแบบไหน ซึ่งเป็นสาเหตุที่ค่า K_v ที่วัดได้เองมักไม่ตรงกับที่ระบุในสเปกของผู้ผลิต

นิยามแรงดัน | ความหมาย | ผลต่อค่า K_v ที่ได้
V ระหว่างขั้ว แบบ RMS | ค่าที่มัลติมิเตอร์ย่าน AC อ่านได้โดยตรง | เป็นค่าที่เราวัดในการทดลองนี้
V ระหว่างขั้ว แบบค่ายอด | เท่ากับ RMS × √2 ถ้ารูปคลื่นเป็นไซน์ | ให้ K_v ต่ำกว่าแบบ RMS ประมาณ 1.41 เท่า
V ต่อเฟส | สำหรับสตาร์ = V ระหว่างขั้ว ÷ √3 | ให้ K_v สูงกว่าแบบระหว่างขั้ว
V บัสไฟตรง | นิยามที่ผู้ผลิตมอเตอร์โดรนมักใช้ | ใกล้เคียงค่ายอดระหว่างขั้ว

ข้อสรุปสำคัญ ค่า K_v สัมบูรณ์ที่วัดได้จะมีความหมายก็ต่อเมื่อระบุนิยามของแรงดันไว้ด้วย แต่ อัตราส่วน ระหว่างมอเตอร์สองตัวไม่ขึ้นกับนิยาม ตราบใดที่ใช้วิธีวัดเดียวกันทั้งสองตัว ดังนั้นการตรวจสอบทฤษฎี 2√3 จึงทำได้อย่างมั่นใจแม้ค่าสัมบูรณ์จะยังมีความไม่แน่นอนอยู่

## 2.5 การประมวลผล — กรณีนี้ต้องบังคับให้เส้นผ่านจุดกำเนิด

ในการทดลองหาค่า K_t เราสรุปไว้ว่า ห้ามบังคับเส้นถดถอยให้ผ่านจุดกำเนิด เพราะระบบมีแรงบิดออฟเซตจาก cogging และแรงเสียดทานสถิตอยู่จริง แต่สำหรับการวัด K_v สถานการณ์กลับกันโดยสิ้นเชิง

e = K_e · ω เมื่อ ω = 0 ต้องได้ e = 0 เสมอ

แรงเคลื่อนไฟฟ้าย้อนกลับเป็นปริมาณทางไฟฟ้าล้วน ไม่มีพจน์แรงเสียดทานเข้ามาเกี่ยวข้อง เมื่อโรเตอร์หยุดนิ่งจึงต้องไม่มีแรงดันออกมาเลย การบังคับให้เส้นผ่านจุดกำเนิดจึงเป็นสิ่งที่ถูกต้องตามฟิสิกส์ และค่าจุดตัดแกนใด ๆ ที่พบจากการฟิตแบบอิสระถือเป็นสัญญาณรบกวนหรือความคลาดเคลื่อนของเครื่องมือ ไม่ใช่ปริมาณทางกายภาพ

บทเรียนเปรียบเทียบ จะบังคับให้เส้นผ่านจุดกำเนิดหรือไม่ ต้องตัดสินจากฟิสิกส์ของสิ่งที่วัด ไม่ใช่จากความสวยงามของกราฟ ในการทดลอง K_t มีออฟเซตทางกายภาพจริงจึงต้องเปิดให้มีจุดตัดแกน ส่วนในการทดลอง K_v ไม่มีออฟเซตทางกายภาพจึงต้องบังคับผ่านศูนย์

## 2.6 ค่าที่คาดการณ์ไว้ล่วงหน้า

จากสเปกของมอเตอร์เดิมที่ระบุ K_v = 335 RPM/V เราคาดว่ามอเตอร์ที่พันใหม่จะได้

K_v (ใหม่) ≈ 335 / 3.464 ≈ 96.7 RPM/V

และจากค่า K_t ที่วัดได้ในการทดลองก่อนหน้า (0.02914 และ 0.10148 N·m/A) จะได้ค่า K_v ที่สอดคล้องกันคือ 327.7 และ 94.1 RPM/V ตามลำดับ

[ วางรูปที่นี่ / Insert image here ]

แผนภาพชุดทดสอบ — มอเตอร์สองตัวต่อประกบหน้าชนหน้า ตัวหนึ่งเป็นต้นกำลัง อีกตัวเป็นเครื่องกำเนิด

รูปที่ 1 แผนภาพชุดทดสอบ — มอเตอร์สองตัวต่อประกบหน้าชนหน้า ตัวหนึ่งเป็นต้นกำลัง อีกตัวเป็นเครื่องกำเนิด

# 3. เทคนิคและวิธีการทดลอง

## 3.1 ชุดทดสอบ

เราใช้มอเตอร์สองตัวต่อประกบกันแบบหน้าชนหน้า โดยยึดแกนของทั้งสองตัวเข้าด้วยกันด้วยข้อต่อ มอเตอร์ตัวหนึ่งทำหน้าที่เป็นต้นกำลังขับให้ระบบหมุน ส่วนมอเตอร์ที่ต้องการทดสอบทำหน้าที่เป็นเครื่องกำเนิดไฟฟ้า และเราวัดแรงดันที่ขั้วของมอเตอร์ตัวที่ทดสอบ

ส่วนประกอบ | หน้าที่ | หมายเหตุ
มอเตอร์ต้นกำลัง | ขับให้ระบบหมุนที่ความเร็วต่าง ๆ | ควบคุมด้วยระดับกำลัง 50, 75 และ 100 %
มอเตอร์ที่ทดสอบ | ทำหน้าที่เป็นเครื่องกำเนิดไฟฟ้า | ไม่ต่อภาระใด ๆ นอกจากมัลติมิเตอร์
ข้อต่อแกน | ยึดแกนทั้งสองให้หมุนด้วยความเร็วเดียวกัน | ต้องได้ศูนย์ดี ไม่ให้เกิดการสั่น
ดิจิทัลแทโคมิเตอร์ | วัดความเร็วรอบจริงของแกน | ใช้แถบสะท้อนแสงติดที่แกนหรือตัวเรือน
มัลติมิเตอร์ย่าน AC | วัดแรงดันแบบ RMS ระหว่างขั้วสองขั้ว | ควรเป็นแบบ True-RMS

ข้อดีของการวัดแบบไม่มีภาระ เนื่องจากขั้วของมอเตอร์ที่ทดสอบต่อกับมัลติมิเตอร์เท่านั้น ซึ่งมีความต้านทานภายในสูงมาก จึงแทบไม่มีกระแสไหลในขดลวด ผลคือไม่มีแรงดันตกคร่อมความต้านทานของขดลวดเลย แรงดันที่วัดได้จึงเป็นแรงเคลื่อนไฟฟ้าย้อนกลับล้วน ๆ ไม่ต้องชดเชยค่า I·R

## 3.2 ขั้นตอนการทดลอง

1. ต่อมอเตอร์สองตัวประกบหน้าชนหน้า ยึดแกนเข้าด้วยกันให้ได้ศูนย์ และยึดตัวเรือนทั้งสองกับฐานให้แน่น
2. ติดแถบสะท้อนแสงสำหรับดิจิทัลแทโคมิเตอร์ และจัดตำแหน่งเครื่องวัดให้อ่านค่าได้นิ่ง
3. ต่อสายมัลติมิเตอร์เข้ากับขั้วสองขั้วของมอเตอร์ที่ต้องการทดสอบ ตั้งย่านวัดเป็นไฟฟ้ากระแสสลับ
4. สั่งมอเตอร์ต้นกำลังให้ทำงานที่ระดับกำลัง 50 % รอให้ความเร็วรอบนิ่งแล้วอ่านค่าความเร็วรอบและแรงดันพร้อมกัน
5. ทำซ้ำที่ระดับกำลัง 75 % และ 100 %
6. คำนวณค่า K_v ของแต่ละจุดจากอัตราส่วนความเร็วรอบต่อแรงดัน แล้วหาค่าเฉลี่ย
7. เปลี่ยนมอเตอร์ที่ทดสอบเป็นอีกตัวหนึ่ง แล้วทำซ้ำทั้งหมดที่ระดับความเร็วเดียวกัน

## 3.3 เทคนิคสำคัญ — จับคู่ความเร็วรอบให้ตรงกันทั้งสองมอเตอร์

ในการทดลองนี้เราวัดมอเตอร์ทั้งสองตัวที่ความเร็วรอบชุดเดียวกัน คือประมาณ 900, 1350 และ 1670 รอบต่อนาที ซึ่งเป็นการออกแบบที่ให้ประโยชน์สำคัญกว่าที่คิด

- ความถี่ของแรงดันเท่ากันทั้งสองมอเตอร์ ที่ 1670 รอบต่อนาที กับมอเตอร์ 7 คู่ขั้ว ความถี่ทางไฟฟ้าอยู่ที่ประมาณ 195 เฮิรตซ์ ถ้ามัลติมิเตอร์มีความคลาดเคลื่อนที่ขึ้นกับความถี่ ความคลาดเคลื่อนนั้นจะเกิดขึ้นเท่ากันทั้งสองมอเตอร์ และหักล้างกันไปเมื่อนำมาหาอัตราส่วน
- รูปคลื่นเหมือนกัน ความคลาดเคลื่อนจากการที่มิเตอร์ไม่ใช่แบบ True-RMS ก็หักล้างกันด้วยเหตุผลเดียวกัน
- ความคลาดเคลื่อนของแทโคมิเตอร์หักล้างกัน เพราะอ่านที่ความเร็วเดียวกัน

ผลที่ได้จากการออกแบบนี้ แม้ค่า K_v สัมบูรณ์จะยังมีความไม่แน่นอนจากนิยามของแรงดันและคุณสมบัติของเครื่องมือ แต่อัตราส่วนระหว่างมอเตอร์สองตัวมีความน่าเชื่อถือสูงมาก ซึ่งอัตราส่วนนี่เองคือสิ่งที่เราต้องการตรวจสอบกับทฤษฎี

## 3.4 เทคนิคอื่นที่ทำให้ผลเชื่อถือได้

- อ่านค่าความเร็วรอบและแรงดันพร้อมกันในจังหวะเดียว เพราะถ้าความเร็วเปลี่ยนระหว่างการอ่านสองค่า อัตราส่วนที่ได้จะผิดทันที
- รอให้ระบบเข้าสู่ความเร็วคงที่ก่อนอ่านค่า และอ่านซ้ำหลายครั้งแล้วเฉลี่ย
- วัดมอเตอร์ทั้งสองตัวในวันเดียวกันด้วยเครื่องมือชุดเดียวกัน เพื่อให้ความคลาดเคลื่อนหักล้างกันได้จริง
- ตรวจสอบว่าแทโคมิเตอร์อ่านความเร็วเชิงกลจริง ไม่ใช่นับจำนวนแถบสะท้อนแสงหลายแถบต่อรอบ ซึ่งจะทำให้อ่านได้เป็นจำนวนเท่าของค่าจริง
- ตรวจสอบย่านความถี่ที่มัลติมิเตอร์รับประกันความแม่นยำ เพราะที่ 195 เฮิรตซ์ มิเตอร์ราคาประหยัดบางรุ่นเริ่มอ่านค่าเพี้ยนแล้ว
- บันทึกให้ชัดเจนว่าวัดแรงดันระหว่างขั้วคู่ใด และเป็นค่าแบบ RMS หรือค่ายอด

# 4. ผลการทดลอง

## 4.1 มอเตอร์เดิม — 20 รอบ/ฟัน ต่อแบบเดลต้า

ระดับกำลัง | ความเร็วรอบ (RPM) | V_rms (V) | K_v (RPM/V)
100 % | 1670.5 | 4.02 | 415.5
75 % | 1350 | 3.27 | 412.8
50 % | 900 | 2.20 | 409.1
ค่าเฉลี่ย | — | — | 412.5

การฟิตเส้นตรงแบบบังคับผ่านจุดกำเนิดให้ค่า K_v = 413.7 RPM/V (R² = 0.99942) ซึ่งใกล้เคียงกับค่าเฉลี่ยรายจุดมาก การกระจายของค่า K_v ทั้งสามจุดอยู่ที่เพียง 1.5 % แสดงว่าความสัมพันธ์เป็นเชิงเส้นดี

## 4.2 มอเตอร์ที่พันใหม่ — 40 รอบ/ฟัน ต่อแบบสตาร์

ระดับกำลัง | ความเร็วรอบ (RPM) | V_rms (V) | K_v (RPM/V)
100 % | 1667 | 14.6 | 114.2
75 % | 1350 | 11.8 | 114.4
50 % | 900 | 7.9 | 113.8
ค่าเฉลี่ย | — | — | 114.1

การฟิตเส้นตรงแบบบังคับผ่านจุดกำเนิดให้ค่า K_v = 114.2 RPM/V (R² = 0.99996) และการกระจายของค่าทั้งสามจุดอยู่ที่เพียง 0.5 % ซึ่งดีกว่ามอเตอร์เดิม เพราะแรงดันที่วัดได้สูงกว่ามาก ความคลาดเคลื่อนสัมพัทธ์จากความละเอียดของมิเตอร์จึงต่ำกว่า

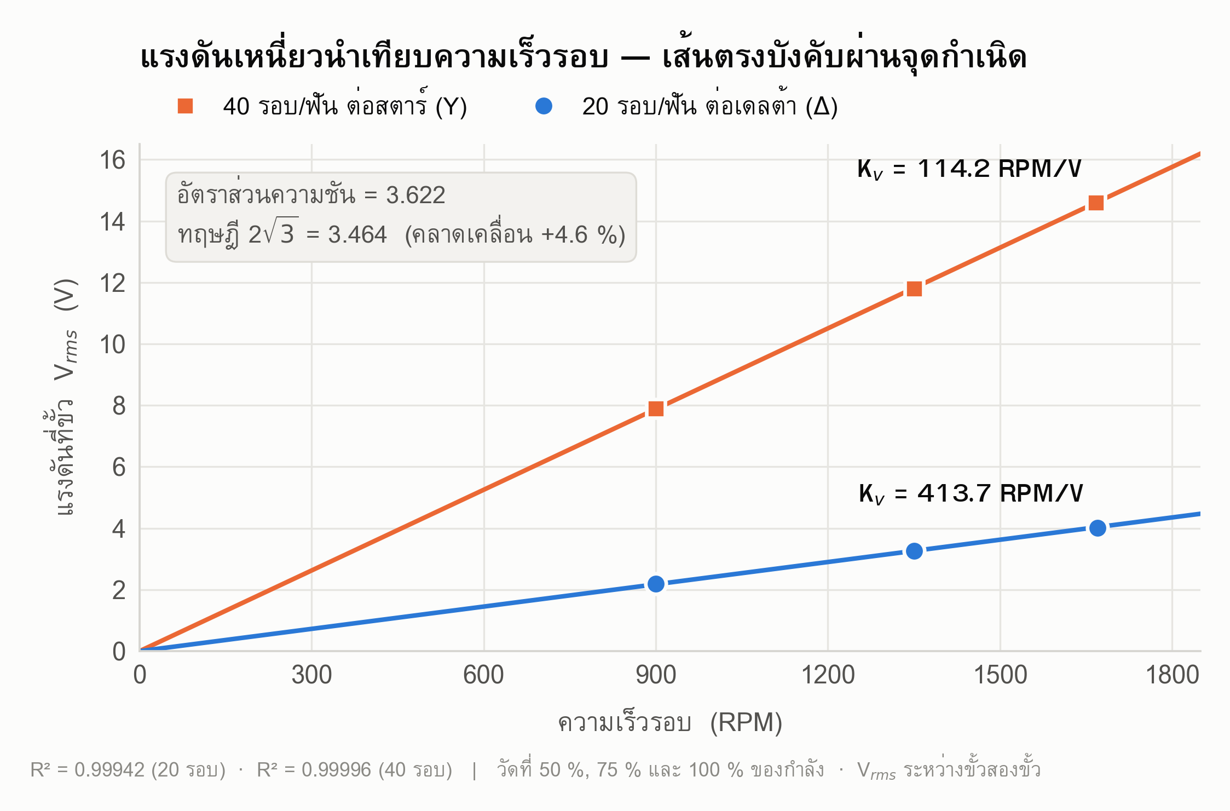
[picture p4: figure]

รูปที่ 2 กราฟแรงดันเทียบความเร็วรอบของมอเตอร์ทั้งสองตัว แสดงความชันที่ต่างกัน

## 4.3 การตรวจสอบกับทฤษฎี

ระดับกำลัง | K_v 20 รอบ (Δ) | K_v 40 รอบ (Y) | อัตราส่วน
100 % | 415.5 | 114.2 | 3.639
75 % | 412.8 | 114.4 | 3.609
50 % | 409.1 | 113.8 | 3.595
จากค่าเฉลี่ย | 412.5 | 114.1 | 3.615

อัตราส่วนที่วัดได้ = 3.615 ทฤษฎี 2√3 = 3.464 คลาดเคลื่อน +4.4 %

ข้อสรุปหลัก อัตราส่วนของค่า K_v ที่วัดได้เท่ากับ 3.615 เทียบกับค่าทฤษฎี 3.464 คลาดเคลื่อนเพียง 4.4 % ซึ่งยืนยันได้ว่าการพันขดลวดใหม่จาก 20 รอบแบบเดลต้าไปเป็น 40 รอบแบบสตาร์ ทำให้ค่า K_v ลดลงตามที่ทฤษฎีทำนายไว้จริง และการวัดนี้เป็นอิสระจากการวัด K_t โดยสิ้นเชิง

อัตราส่วนที่คำนวณแยกรายจุดอยู่ในช่วง 3.595 ถึง 3.639 กระจายกันเพียง 1.3 % และมีแนวโน้มเพิ่มขึ้นเล็กน้อยเมื่อความเร็วสูงขึ้น ซึ่งอาจเกิดจากความคลาดเคลื่อนของมัลติมิเตอร์ที่ขึ้นกับความถี่ หรือจากความละเอียดในการอ่านแรงดันของมอเตอร์เดิมที่มีแรงดันต่ำเพียง 2.2 ถึง 4.02 โวลต์

## 4.4 ข้อสังเกตสำคัญ — ค่าสัมบูรณ์สูงกว่าสเปกของผู้ผลิตประมาณ 23 %

มอเตอร์เดิมระบุในสเปกไว้ที่ 335 RPM/V แต่ค่าที่เราวัดได้คือ 412.5 RPM/V ซึ่งสูงกว่าถึง 23 % ความต่างนี้ไม่ได้แปลว่าการวัดผิด แต่เกิดจากนิยามของแรงดันที่ต่างกันตามที่อธิบายไว้ในข้อ 2.4

ตารางด้านล่างแสดงว่าถ้าใช้นิยามแรงดันแบบต่าง ๆ จะได้ค่า K_t ที่คำนวณออกมาเป็นเท่าไร แล้วนำไปเทียบกับค่า K_t ที่วัดได้โดยตรงจากการทดลองแรงบิด

นิยามแรงดัน (มอเตอร์ 20 รอบ) | K_v | K_t ที่คำนวณได้ | เทียบ K_t ที่วัดได้ 0.02914
V_rms ระหว่างขั้ว (ที่วัดจริง) | 412.5 | 0.02315 | ต่ำไป 21 %
ค่ายอด = RMS × √2 | 291.7 | 0.03274 | สูงไป 12 %
แก้ด้วยตัวคูณ 1.23 | 335.1 | 0.02850 | ต่างเพียง 2.2 %

นิยามแรงดัน (มอเตอร์ 40 รอบ) | K_v | K_t ที่คำนวณได้ | เทียบ K_t ที่วัดได้ 0.10148
V_rms ระหว่างขั้ว (ที่วัดจริง) | 114.1 | 0.08364 | ต่ำไป 18 %
ค่ายอด = RMS × √2 | 80.7 | 0.11829 | สูงไป 17 %
แก้ด้วยตัวคูณ 1.23 | 92.7 | 0.10296 | ต่างเพียง 1.5 %

สิ่งที่น่าสนใจคือ ตัวคูณแก้ค่าเพียงตัวเดียวคือประมาณ 1.23 ทำให้ผลทั้งสามแหล่งสอดคล้องกันหมด ทั้งสเปกของผู้ผลิต ค่า K_v ที่เราวัดได้ และค่า K_t ที่วัดจากแรงบิด โดยมอเตอร์เดิมได้ 335.1 ตรงกับสเปก 335 พอดี ส่วนมอเตอร์ใหม่ได้ค่า K_t ที่คำนวณได้ 0.10296 ต่างจากที่วัดจริงเพียง 1.5 %

ตัวคูณ 1.23 นี้ไม่เท่ากับ √2 = 1.414 ที่คาดไว้สำหรับรูปคลื่นไซน์บริสุทธิ์ แสดงว่ารูปคลื่นของแรงเคลื่อนไฟฟ้าย้อนกลับไม่ใช่ไซน์สมบูรณ์ หรือมัลติมิเตอร์ที่ใช้ไม่ใช่แบบ True-RMS หรือทั้งสองอย่างประกอบกัน การจับภาพรูปคลื่นด้วยออสซิลโลสโคปจะปิดคำถามนี้ได้ทันที

ผลกระทบต่อข้อสรุปหลัก ไม่มีผลต่อการตรวจสอบทฤษฎี เพราะตัวคูณแก้ค่านี้เหมือนกันทั้งสองมอเตอร์ จึงหักล้างกันไปเมื่อคิดเป็นอัตราส่วน อัตราส่วน 3.615 ที่ได้จึงยังใช้ได้เต็มที่ แต่ถ้าจะนำค่า K_v สัมบูรณ์ไปใช้ที่อื่น ต้องระบุนิยามของแรงดันกำกับไว้เสมอ

## 4.5 การตรวจสอบไขว้กับผลการทดลองอื่น

แหล่งข้อมูล | อัตราส่วน | คลาดเคลื่อนจาก 3.464 | ลักษณะของการวัด
ทฤษฎี 2√3 | 3.464 | ค่าอ้างอิง | —
จากการวัด K_t | 3.483 | +0.5 % | วัดแรงบิด มีแรงเสียดทานปน
จากการวัด K_v (การทดลองนี้) | 3.615 | +4.4 % | วัดแรงดัน ไม่มีแรงเสียดทานปน

ความสอดคล้องของทั้งสามแหล่ง การวัดสองวิธีที่เป็นอิสระจากกันโดยสิ้นเชิง คือวัดจากแรงบิดกับวัดจากแรงดัน ให้อัตราส่วนที่ต่างกันเพียง 3.8 % และทั้งคู่ตรงกับทฤษฎีภายใน 5 % ซึ่งเป็นการยืนยันที่หนักแน่นมากว่าการพันขดลวดใหม่ได้จำนวนรอบครบและต่อปลายขดลวดถูกต้องตามที่ออกแบบ

# 5. ปัญหาที่พบและแนวทางแก้ไข

## 5.1 ปัญหาที่พบจากผลการทดลองจริง

ปัญหาที่พบ | สาเหตุ | วิธีแก้
ค่า K_v ที่วัดได้สูงกว่าสเปกของผู้ผลิตถึง 23 % | นิยามของแรงดันต่างกัน สเปกของผู้ผลิตมักอ้างอิงแรงดันบัสไฟตรงซึ่งใกล้ค่ายอด ในขณะที่เราวัดค่า RMS ระหว่างขั้ว | ระบุนิยามของแรงดันกำกับทุกครั้ง และใช้ตัวคูณแก้ค่าประมาณ 1.23 เมื่อต้องเทียบกับสเปก หรือจับภาพรูปคลื่นด้วยออสซิลโลสโคปเพื่อหาความสัมพันธ์ที่แท้จริง
ตัวคูณแก้ค่าที่ได้ (1.23) ไม่เท่ากับ √2 ที่คาดไว้ | รูปคลื่นแรงเคลื่อนไฟฟ้าย้อนกลับไม่ใช่ไซน์สมบูรณ์ และมัลติมิเตอร์อาจไม่ใช่แบบ True-RMS | ใช้มัลติมิเตอร์แบบ True-RMS และจับภาพรูปคลื่นด้วยออสซิลโลสโคปเพื่อวัดทั้งค่ายอดและค่า RMS พร้อมกัน
อัตราส่วนของค่า K_v (3.615) สูงกว่าอัตราส่วนที่ได้จาก K_t (3.483) อยู่ 3.8 % | ความคลาดเคลื่อนของการอ่านแรงดันที่ต่ำมากของมอเตอร์เดิม และผลของความถี่ต่อมัลติมิเตอร์ | เพิ่มจำนวนจุดข้อมูลและวัดซ้ำ ใช้เครื่องมือที่มีความละเอียดสูงขึ้นสำหรับแรงดันต่ำ
ค่า K_v ของมอเตอร์เดิมกระจาย 1.5 % ในขณะที่มอเตอร์ใหม่กระจายเพียง 0.5 % | แรงดันของมอเตอร์เดิมต่ำเพียง 2.2 ถึง 4.02 โวลต์ ความละเอียด 0.01 โวลต์จึงคิดเป็นสัดส่วนที่สูงกว่า | ขับที่ความเร็วรอบสูงขึ้นเพื่อให้ได้แรงดันสูงขึ้น หรือใช้มิเตอร์ที่มีความละเอียดมากกว่าสำหรับมอเตอร์เดิม
มีเพียงสามจุดข้อมูลต่อมอเตอร์ | ทดสอบเพียงสามระดับกำลัง | เพิ่มเป็น 6 ถึง 8 ระดับความเร็ว และวัดซ้ำแต่ละจุดอย่างน้อย 3 ครั้ง เพื่อประเมินความไม่แน่นอนได้

## 5.2 ปัญหาด้านชุดทดสอบและเครื่องมือ

ปัญหาที่พบ | สาเหตุ | วิธีแก้
ความถี่ของแรงดันที่วัดสูงถึงประมาณ 195 เฮิรตซ์ | ที่ 1670 รอบต่อนาที กับมอเตอร์ 7 คู่ขั้ว ความถี่ทางไฟฟ้าเท่ากับความเร็วรอบหารหกสิบคูณจำนวนคู่ขั้ว มัลติมิเตอร์ราคาประหยัดหลายรุ่นรับประกันความแม่นยำเฉพาะย่านความถี่ต่ำ | ตรวจสอบสเปกย่านความถี่ของมิเตอร์ก่อนใช้ และเนื่องจากเราวัดทั้งสองมอเตอร์ที่ความเร็วเดียวกัน ความคลาดเคลื่อนนี้จึงหักล้างกันในอัตราส่วนอยู่แล้ว
ความเร็วรอบไม่นิ่งขณะอ่านค่า | ระดับกำลังของมอเตอร์ต้นกำลังยังไม่เข้าที่ หรือมีการสั่นจากการต่อแกนไม่ได้ศูนย์ | รอให้ความเร็วนิ่งก่อนอ่าน ตรวจการจัดศูนย์ของข้อต่อแกน และอ่านความเร็วกับแรงดันพร้อมกันในจังหวะเดียว
แทโคมิเตอร์อ่านค่าเป็นจำนวนเท่าของค่าจริง | ติดแถบสะท้อนแสงหลายแถบต่อรอบ ทำให้เครื่องนับได้หลายครั้งต่อหนึ่งรอบ | ติดแถบสะท้อนแสงเพียงแถบเดียว และตรวจสอบค่าที่อ่านได้เทียบกับค่าที่คาดจากระดับกำลัง
ค่าความเร็วที่บันทึกได้เป็นเลขกลม เช่น 900 และ 1350 พอดี | อาจเป็นค่าที่ตั้งไว้มากกว่าค่าที่วัดได้จริง หรือความละเอียดของการอ่านจำกัด | บันทึกค่าที่อ่านได้จากแทโคมิเตอร์จริงพร้อมทศนิยม และระบุความละเอียดของเครื่องมือไว้ในรายงาน
วัดแรงดันคนละคู่ขั้วในสองมอเตอร์ | ไม่ได้บันทึกไว้ว่าวัดคู่ไหน | บันทึกคู่ขั้วที่วัดทุกครั้ง และวัดครบทั้งสามคู่แล้วเฉลี่ย เพื่อตรวจความสมมาตรของสามเฟสไปพร้อมกัน

## 5.3 ข้อควรระวังในการตีความ

- ค่า K_v สัมบูรณ์ต้องระบุนิยามของแรงดันกำกับเสมอ มิฉะนั้นตัวเลขจะเทียบกับแหล่งอื่นไม่ได้ ส่วนอัตราส่วนระหว่างมอเตอร์สองตัวใช้ได้โดยไม่ต้องระบุ
- การวัดนี้ไม่ได้ยืนยันขนาดลวดหรือความต้านทาน เพราะแรงเคลื่อนไฟฟ้าย้อนกลับไม่ขึ้นกับขนาดลวดเลย ต้องดูผลจากการวัดความต้านทานควบคู่กันไปด้วย
- ค่า K_v เปลี่ยนตามอุณหภูมิ เพราะแม่เหล็กนีโอดิเมียมมีความเข้มลดลงประมาณ 0.11 เปอร์เซ็นต์ต่อองศาเซลเซียส เมื่อมอเตอร์ร้อนขึ้นค่า K_v จะสูงขึ้นเล็กน้อย จึงควรวัดขณะมอเตอร์เย็นและจดอุณหภูมิไว้
- การวัดแบบไม่มีภาระวัดเฉพาะแรงเคลื่อนไฟฟ้าย้อนกลับ ไม่ครอบคลุมพฤติกรรมขณะมีกระแสไหล ซึ่งจะมีแรงดันตกคร่อมความต้านทานและความเหนี่ยวนำเพิ่มเข้ามา

# 6. สรุปและงานถัดไป

การทดลองนี้ยืนยันด้วยวิธีที่เป็นอิสระจากการวัดแรงบิดโดยสิ้นเชิงว่า การพันขดลวดใหม่จาก 20 รอบแบบเดลต้าไปเป็น 40 รอบแบบสตาร์ ทำให้ค่าคงตัวความเร็วลดลง 3.615 เท่า เทียบกับค่าทฤษฎี 2√3 = 3.464 คลาดเคลื่อนเพียง 4.4 % และเมื่อนำไปเทียบกับอัตราส่วนที่ได้จากการวัด K_t ซึ่งเท่ากับ 3.483 พบว่าทั้งสองวิธีต่างกันเพียง 3.8 %

บทเรียนเชิงวิธีการที่สำคัญมีสองข้อ ข้อแรกคือการวัดมอเตอร์ทั้งสองตัวที่ความเร็วรอบชุดเดียวกัน ทำให้ความคลาดเคลื่อนของเครื่องมือที่ขึ้นกับความถี่และรูปคลื่นหักล้างกันไปในอัตราส่วน ข้อที่สองคือการตัดสินว่าจะบังคับให้เส้นถดถอยผ่านจุดกำเนิดหรือไม่ ต้องดูจากฟิสิกส์ของสิ่งที่วัด ในการทดลอง K_v ต้องบังคับผ่านศูนย์เพราะแรงเคลื่อนไฟฟ้าย้อนกลับเป็นศูนย์เมื่อไม่หมุน ซึ่งตรงข้ามกับการทดลอง K_t ที่มีออฟเซตทางกายภาพจริง

งานถัดไปที่ต้องดำเนินการ:

1. จับภาพรูปคลื่นแรงเคลื่อนไฟฟ้าย้อนกลับด้วยออสซิลโลสโคป เพื่อหาความสัมพันธ์ระหว่างค่ายอดกับค่า RMS ที่แท้จริง และปิดคำถามเรื่องตัวคูณ 1.23
2. วัดซ้ำโดยเพิ่มจำนวนระดับความเร็วเป็น 6 ถึง 8 จุด และวัดซ้ำแต่ละจุดอย่างน้อย 3 ครั้ง พร้อมรายงานค่าเบี่ยงเบนมาตรฐาน
3. วัดครบทั้งสามคู่ขั้วของแต่ละมอเตอร์ เพื่อตรวจความสมมาตรของสามเฟสไปพร้อมกัน
4. ใช้มัลติมิเตอร์แบบ True-RMS ที่รับประกันความแม่นยำถึงย่านความถี่อย่างน้อย 500 เฮิรตซ์
5. จดอุณหภูมิของมอเตอร์ทุกครั้งที่วัด และทดสอบผลของความร้อนต่อค่า K_v
6. รวบรวมผลของทั้งสามการทดลอง คือความต้านทาน K_t และ K_v มาเขียนเป็นตารางสรุปคุณสมบัติของมอเตอร์ทั้งสองตัว แล้วคำนวณค่าคงตัวมอเตอร์ K_m เพื่อยืนยันว่าการพันใหม่ไม่ได้เปลี่ยนประสิทธิภาพเชิงกลของมอเตอร์

## บันทึกเพิ่มเติม

ExArMo — Logbook: Motor Kv Measurement | หน้า /
